calperxd/tangnano9k-kr260-hat/hardware/renders/pcb_iso_bottom.png

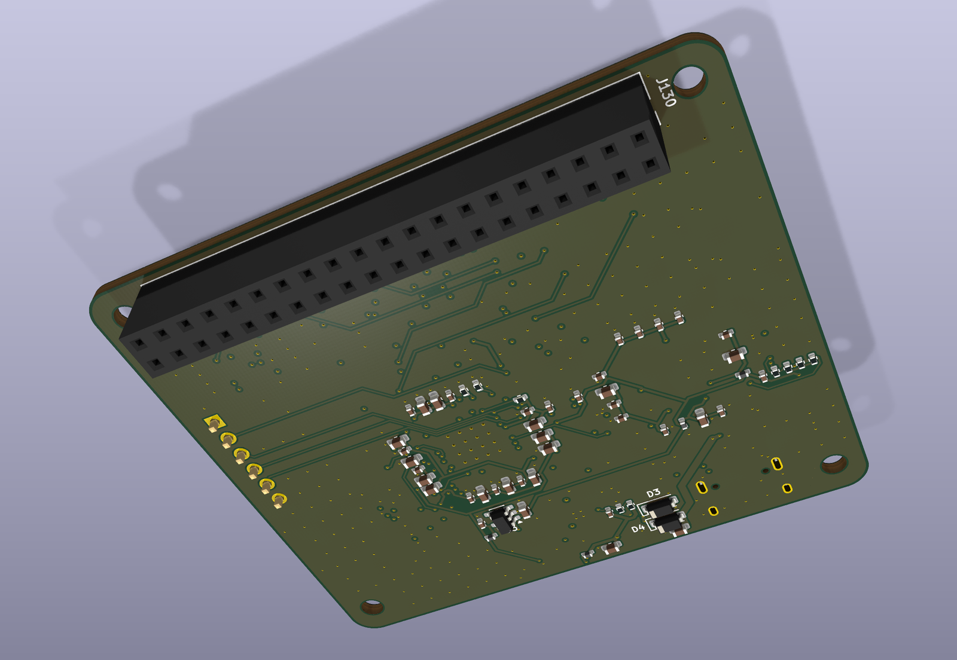
hardware/renders/pcb_iso_bottom.png
