calperxd/tangnano9k-kr260-hat/hardware/production/jlcpcb_parts.csv

Value|Footprint | Qty | LCSC | Manufacturer | MPN | Note
18pF|C_0402_1005Metric | 3 | C1549 | FH Guangdong Fenghua Advanced Tech | 0402CG180J500NT | basic part
10uF|C_0603_1608Metric | 17 | C19702 | Samsung Electro Mechanics | CL10A106KP8NNNC | basic part
22uF|C_0603_1608Metric | 4 | C86295 | Samsung | CL10A226MP8NUNE | 10 V X5R; on +5V and PWR_1V8_RAW
2.2uF|C_0402_1005Metric | 3 | C386077 | Taiyo Yuden | TMK105CBJ225KV-F | 25 V; C10/C13 on +5V
100nF|C_0402_1005Metric | 30 | C1525 | Samsung | CL05B104KO5NNNC | basic part
4.7uF|C_0603_1608Metric | 2 | C19666 | Samsung Electro Mechanics | CL10A475KO8NNNC | basic part
3.3uF|C_0603_1608Metric | 1 | C51412 | Samsung Electro Mechanics | CL10A335KP8NNNC
27pF|C_0402_1005Metric | 2 | C1557 | FH Guangdong Fenghua Advanced Tech | 0402CG270J500NT
SMAJ5.0A|D_SMA | 1 | C83329 | Littelfuse | SMAJ5.0A
B5819W|D_SOD-123 | 2 | C8598 | Jiangsu Changjing Electronics Technology Co Ltd | B5819W SL | basic part; USB-C / J21 5V OR-ing (D3/D4)
LED orange (power)|LED_0603_1608Metric | 1 | C157740 | Lite-On | LTST-C190KFKT
0402ESDA-05N|D_0402_1005Metric | 7 | C316049 | BORN | 0402ESDA-05N
LED orange|LED_0603_1608Metric | 6 | C157740 | Lite-On | LTST-C190KFKT
PTC 0.5A hold (size per PWR-04)|Fuse_1206_3216Metric | 1 | C70077 | TECHFUSE | nSMD050-33V | 0.5 A hold; rating still Pending (PWR-04)
UPZ1005D121-1R3TF|L_0402_1005Metric | 7 | C96993 | Sunlord | UPZ1005D121-1R3TF
USB_C_USB2.0_16P|USB_C_Receptacle_HRO_TYPE-C-31-M-12 | 1 | C165948 | Korean Hroparts Elec | TYPE-C-31-M-12
microSD (TF)|microSD_HC_Molex_104031-0811 | 1 | C585350 | MOLEX | 1040310811
JTAG ext. 1V8|PinHeader_1x06_P2.54mm_Vertical | 1 | C492405 | XFCN | PZ254V-11-06P | THT; optional external JTAG header
KR260 J21 (2x20 female, bottom side)|PinSocket_2x20_P2.54mm_Vertical | 1 | C132132 | CONNFLY | DS1023-2*20SF11 | THT on the bottom side; 8.5 mm insulator height, stack height Pending (XTP744)
2.2uH|L_Murata_DFE201610P | 3 | C237554 | Murata Electronics | DFE201610P-2R2M=P2
5.1k|R_0402_1005Metric | 2 | C25905 | UNI ROYAL Uniroyal Elec | 0402WGF5101TCE | basic part
680k|R_0402_1005Metric | 2 | C163456 | YAGEO | RC0402FR-07680KL
150k|R_0402_1005Metric | 3 | C25755 | UNI ROYAL Uniroyal Elec | 0402WGF1503TCE
300k|R_0402_1005Metric | 1 | C25774 | UNI ROYAL Uniroyal Elec | 0402WGF3003TCE
1k|R_0402_1005Metric | 2 | C11702 | UNI ROYAL Uniroyal Elec | 0402WGF1001TCE | basic part
4.7k|R_0402_1005Metric | 7 | C25900 | UNI ROYAL Uniroyal Elec | 0402WGF4701TCE | basic part
10k|R_0402_1005Metric | 10 | C25744 | UNI ROYAL Uniroyal Elec | 0402WGF1002TCE | basic part
22R|R_0402_1005Metric | 21 | C25092 | UNI ROYAL Uniroyal Elec | 0402WGF220JTCE | basic part
0R|R_0402_1005Metric | 1 | C17168 | UNI ROYAL Uniroyal Elec | 0402WGF0000TCE | basic part
12k 1%|R_0402_1005Metric | 1 | C25752 | UNI ROYAL Uniroyal Elec | 0402WGF1202TCE | basic part
2.2k|R_0402_1005Metric | 1 | C25879 | UNI ROYAL Uniroyal Elec | 0402WGF2201TCE | basic part
3.3k|R_0402_1005Metric | 3 | C25890 | UNI ROYAL Uniroyal Elec | 0402WGF3301TCE | basic part
100k|R_0402_1005Metric | 2 | C25741 | UNI ROYAL Uniroyal Elec | 0402WGF1003TCE | basic part
S1 (user button)|SW_SPST_PTS810 | 1 | C221895 | C&K | PTS810SJG250SMTRLFS
S2 (user button, JTAGSEL_N)|SW_SPST_PTS810 | 1 | C221895 | C&K | PTS810SJG250SMTRLFS
USBLC6-2SC6|SOT-23-6 | 1 | C7519 | STMicroelectronics | USBLC6-2SC6
TMI7003C|QFN-20-1EP_3x3mm_P0.4mm_EP1.65x1.65mm | 1 | C840566 | TMI | TMI7003C | extended part; pinout and 2.5-5.5 V input checked against datasheet V1.5
ME6211C12M5|SOT-23-5 | 1 | C236672 | MICRONE Nanjing Micro One Elec | ME6211C12M5G-N
GW1NR-LV9QN88PC6/I5|GW1NR_QN88P_10x10mm_P0.4mm_EP6.8mm | 1 |  | Gowin | GW1NR-LV9QN88PC6/I5 | not in the JLCPCB stock snapshot: Global Sourcing or consigned
W25Q32JVZPIQ|WSON-8-1EP_6x5mm_P1.27mm_EP3.4x4mm | 1 | C571260 | Winbond | W25Q32JVZPIQ | Proposed replacement for P25Q32U
FT2232HL|LQFP-64_10x10mm_P0.5mm | 1 | C27882 | FTDI | FT2232HL-REEL
93LC56B|SOIC-8_3.9x4.9mm_P1.27mm | 1 | C6164 | Microchip Tech | 93LC56BT-I/SN
SN74AVC4T774PW|TSSOP-16_4.4x5mm_P0.65mm | 1 | C129363 | Texas Instruments | SN74AVC4T774PWR
74LVC244A|TSSOP-20_4.4x6.5mm_P0.65mm | 3 | C7668 | Texas Instruments | SN74LVC244APWR
74LVC3G17|VSSOP-8_2.3x2mm_P0.5mm | 1 | C68245 | Texas Instruments | SN74LVC3G17DCUR | TI part required for Ioff (ISO-13)
74LVC1G00|SOT-23-5 | 1 | C7826 | Texas Instruments | SN74LVC1G00DBVR | TI part required for Ioff (ISO-06)
27MHz|Oscillator_SMD_Abracon_ASE-4Pin_3.2x2.5mm | 1 | C20617591 | YXC | OT2JI-111-27M | CMOS, 1.8-3.3 V, +/-20 ppm; powered from +3V3
12MHz ±30ppm|Crystal_SMD_3225-4Pin_3.2x2.5mm | 1 | C9002 | YXC Crystal Oscillators | X322512MSB4SI | basic part
