calperxd/tangnano9k-kr260-hat/docs/pinout-j21.csv

j21_pin | kr260_net | carrier_components | som_pin | k26_package_pin | k26_bank_vcco | k26_function | hat_net | gowin_pin_bank | direction | power_off_state | source | hat_silkscreen
1 | RPI_3V3 | U74 STMPS2161STR power switch, PL_3V3 → RPI_3V3 | — | — | — | Not applicable: 3.3 V power (RPi pinout, S3) | Proposed: no power connection on the HAT (ISO-01, ISO-02) | — | Proposed: not applicable (KR260 power, not used by the HAT) | Proposed: no connection on the HAT; no interconnection of supplies (ISO-01, ISO-02) | F12 (carrier schematic 038-05101-01 rev A02) sheet 12; same as S3 (standard Raspberry Pi pinout); allocation: rev. 0.4 proposal (preliminary schematic hardware/) | 3V3
2 | RPI_5V0 | U73 STMPS2161STR power switch, 5V0_IN → RPI_5V0 | — | — | — | Not applicable: 5 V power (RPi pinout, S3) | Proposed: J21_5V, the HAT 5 V input: to +5V through the Schottky D4 (B5819W), OR-ed with the USB-C through D3 (PWR-01, Decided in rev. 0.6); 10 µF C14 on the input | — | Proposed: KR260 → HAT power (RPI_5V0, 1.0 A per rail, F1) | Proposed: D4 keeps the HAT +5V (from the USB-C) out of the KR260 5 V; no interconnection of supplies (ISO-01, ISO-04) | F12 (carrier schematic 038-05101-01 rev A02) sheet 12; same as S3 (standard Raspberry Pi pinout); allocation: rev. 0.4 proposal (preliminary schematic hardware/) | 5V
3 | RPI_GPIO2_SDA (HDC02) | 4.70k pull-up to RPI_3V3 (R326/R327 on contacts 3/5) | som240_2_d54 | AE15 | Bank 44 (all 24 I/Os of the bank on J21, according to S1/F11); VCCO = PL_3V3 (VCCO_HDC, F12 sheet 7; bank VCCO pin som240_2_d59 in F13); I/O standard in S1: LVCMOS33 | PL (S1); IO_L1P_AD15P_44; RPi signal GPIO2 (I²C SDA); no HDGC | Proposed: reserved, no connection on the HAT (the carrier pulls GPIO2/3 up to RPI_3V3 with 4.70k, R326/R327, F12) | Proposed: no connection to the Gowin | Proposed: unused by the HAT (reserved) | Proposed: not driven by the HAT (no connection; ISO-09) | F12 (carrier schematic 038-05101-01 rev A02) sheet 12: J21 → HDC02, sheet 7: HDC02 → som240_2_d54; F13 (Kria_K26_SOM_Rev1.xdc): som240_2_d54 → AE15 (IO_L1P_AD15P_44, bank 44); same as S1 (XDC Hackster 2022) and F11 (xczu5evsfvc784pkg.txt); consistent with S2 (LogicTronix); allocation: rev. 0.4 proposal (preliminary schematic hardware/) | NC
4 | RPI_5V0 | U73 STMPS2161STR power switch, 5V0_IN → RPI_5V0 | — | — | — | Not applicable: 5 V power (RPi pinout, S3) | Proposed: J21_5V, the HAT 5 V input: to +5V through the Schottky D4 (B5819W), OR-ed with the USB-C through D3 (PWR-01, Decided in rev. 0.6); 10 µF C14 on the input | — | Proposed: KR260 → HAT power (RPI_5V0, 1.0 A per rail, F1) | Proposed: D4 keeps the HAT +5V (from the USB-C) out of the KR260 5 V; no interconnection of supplies (ISO-01, ISO-04) | F12 (carrier schematic 038-05101-01 rev A02) sheet 12; same as S3 (standard Raspberry Pi pinout); allocation: rev. 0.4 proposal (preliminary schematic hardware/) | 5V
5 | RPI_GPIO3_SCL (HDC03) | 4.70k pull-up to RPI_3V3 (R326/R327 on contacts 3/5) | som240_2_d56 | AE14 | Bank 44 (all 24 I/Os of the bank on J21, according to S1/F11); VCCO = PL_3V3 (VCCO_HDC, F12 sheet 7; bank VCCO pin som240_2_d59 in F13); I/O standard in S1: LVCMOS33 | PL (S1); IO_L1N_AD15N_44; RPi signal GPIO3 (I²C SCL); no HDGC | Proposed: reserved, no connection on the HAT (the carrier pulls GPIO2/3 up to RPI_3V3 with 4.70k, R326/R327, F12) | Proposed: no connection to the Gowin | Proposed: unused by the HAT (reserved) | Proposed: not driven by the HAT (no connection; ISO-09) | F12 (carrier schematic 038-05101-01 rev A02) sheet 12: J21 → HDC03, sheet 7: HDC03 → som240_2_d56; F13 (Kria_K26_SOM_Rev1.xdc): som240_2_d56 → AE14 (IO_L1N_AD15N_44, bank 44); same as S1 (XDC Hackster 2022) and F11 (xczu5evsfvc784pkg.txt); consistent with S2 (LogicTronix); allocation: rev. 0.4 proposal (preliminary schematic hardware/) | NC
6 | GND | none (GND) | — | — | — | Not applicable: GND (RPi pinout, S3) | Proposed: GND, connected to the HAT ground plane (ISO-03) | — | Proposed: not applicable (GND) | Proposed: GND always connected to the plane (ISO-03) | F12 (carrier schematic 038-05101-01 rev A02) sheet 12; same as S3 (standard Raspberry Pi pinout); allocation: rev. 0.4 proposal (preliminary schematic hardware/) | GND
7 | RPI_GPIO4_GPCLK0 (HDC04) | none (direct to SOM240_2) | som240_2_d57 | AG14 | Bank 44 (all 24 I/Os of the bank on J21, according to S1/F11); VCCO = PL_3V3 (VCCO_HDC, F12 sheet 7; bank VCCO pin som240_2_d59 in F13); I/O standard in S1: LVCMOS33 | PL (S1); IO_L2P_AD14P_44; RPi signal GPIO4; no HDGC | Proposed: LINK_D0 (bit order revisable during routing) | Proposed: GW1NR pin 68 (IOT42B), bank 1, VCCIO1 3.3 V; via U130 1A2→1Y2, R132 22R | Proposed: HAT → KR260; driver enabled only with LINK_OE_N low (OE in hardware: NAND of LINK_EN and LINK_TX_EN, ISO-11/ISO-15) | Proposed: before LINK_EN is high, HAT driver (74LVC244A, Ioff) in high impedance, no pull proposed | F12 (carrier schematic 038-05101-01 rev A02) sheet 12: J21 → HDC04, sheet 7: HDC04 → som240_2_d57; F13 (Kria_K26_SOM_Rev1.xdc): som240_2_d57 → AG14 (IO_L2P_AD14P_44, bank 44); same as S1 (XDC Hackster 2022) and F11 (xczu5evsfvc784pkg.txt); allocation: rev. 0.4 proposal (preliminary schematic hardware/) | D0
8 | RPI_GPIO14_TXD (HDC14) | none (direct to SOM240_2) | som240_2_b54 | W14 | Bank 44 (all 24 I/Os of the bank on J21, according to S1/F11); VCCO = PL_3V3 (VCCO_HDC, F12 sheet 7; bank VCCO pin som240_2_d59 in F13); I/O standard in S1: LVCMOS33 | PL (S1); IO_L9P_AD11P_44; RPi signal GPIO14; no HDGC | Proposed: LINK_D1 (bit order revisable during routing) | Proposed: GW1NR pin 69 (IOT42A), bank 1, VCCIO1 3.3 V; via U130 1A3→1Y3, R133 22R | Proposed: HAT → KR260; driver enabled only with LINK_OE_N low (OE in hardware: NAND of LINK_EN and LINK_TX_EN, ISO-11/ISO-15) | Proposed: before LINK_EN is high, HAT driver (74LVC244A, Ioff) in high impedance, no pull proposed | F12 (carrier schematic 038-05101-01 rev A02) sheet 12: J21 → HDC14, sheet 7: HDC14 → som240_2_b54; F13 (Kria_K26_SOM_Rev1.xdc): som240_2_b54 → W14 (IO_L9P_AD11P_44, bank 44); same as S1 (XDC Hackster 2022) and F11 (xczu5evsfvc784pkg.txt); allocation: rev. 0.4 proposal (preliminary schematic hardware/) | D1
9 | GND | none (GND) | — | — | — | Not applicable: GND (RPi pinout, S3) | Proposed: GND, connected to the HAT ground plane (ISO-03) | — | Proposed: not applicable (GND) | Proposed: GND always connected to the plane (ISO-03) | F12 (carrier schematic 038-05101-01 rev A02) sheet 12; same as S3 (standard Raspberry Pi pinout); allocation: rev. 0.4 proposal (preliminary schematic hardware/) | GND
10 | RPI_GPIO15_RXD (HDC15) | none (direct to SOM240_2) | som240_2_b56 | W13 | Bank 44 (all 24 I/Os of the bank on J21, according to S1/F11); VCCO = PL_3V3 (VCCO_HDC, F12 sheet 7; bank VCCO pin som240_2_d59 in F13); I/O standard in S1: LVCMOS33 | PL (S1); IO_L9N_AD11N_44; RPi signal GPIO15; no HDGC | Proposed: LINK_D2 (bit order revisable during routing) | Proposed: GW1NR pin 70 (IOT41B), bank 1, VCCIO1 3.3 V; via U130 2A0→2Y0, R134 22R | Proposed: HAT → KR260; driver enabled only with LINK_OE_N low (OE in hardware: NAND of LINK_EN and LINK_TX_EN, ISO-11/ISO-15) | Proposed: before LINK_EN is high, HAT driver (74LVC244A, Ioff) in high impedance, no pull proposed | F12 (carrier schematic 038-05101-01 rev A02) sheet 12: J21 → HDC15, sheet 7: HDC15 → som240_2_b56; F13 (Kria_K26_SOM_Rev1.xdc): som240_2_b56 → W13 (IO_L9N_AD11N_44, bank 44); same as S1 (XDC Hackster 2022) and F11 (xczu5evsfvc784pkg.txt); allocation: rev. 0.4 proposal (preliminary schematic hardware/) | D2
11 | RPI_GPIO17 (HDC17) | none (direct to SOM240_2) | som240_2_b58 | AB14 | Bank 44 (all 24 I/Os of the bank on J21, according to S1/F11); VCCO = PL_3V3 (VCCO_HDC, F12 sheet 7; bank VCCO pin som240_2_d59 in F13); I/O standard in S1: LVCMOS33 | PL (S1); IO_L8N_HDGC_44; RPi signal GPIO17; HDGC N side: with a single-ended clock on the P side, regular I/O only (F7) | Proposed: LINK_D3 (bit order revisable during routing) | Proposed: GW1NR pin 71 (IOT41A), bank 1, VCCIO1 3.3 V; via U130 2A1→2Y1, R135 22R | Proposed: HAT → KR260; driver enabled only with LINK_OE_N low (OE in hardware: NAND of LINK_EN and LINK_TX_EN, ISO-11/ISO-15) | Proposed: before LINK_EN is high, HAT driver (74LVC244A, Ioff) in high impedance, no pull proposed | F12 (carrier schematic 038-05101-01 rev A02) sheet 12: J21 → HDC17, sheet 7: HDC17 → som240_2_b58; F13 (Kria_K26_SOM_Rev1.xdc): som240_2_b58 → AB14 (IO_L8N_HDGC_44, bank 44); same as S1 (XDC Hackster 2022) and F11 (xczu5evsfvc784pkg.txt); HDGC: F5, F7; allocation: rev. 0.4 proposal (preliminary schematic hardware/) | D3
12 | RPI_GPIO18_PCM_CLK (HDC18) | none (direct to SOM240_2) | som240_2_a54 | Y14 | Bank 44 (all 24 I/Os of the bank on J21, according to S1/F11); VCCO = PL_3V3 (VCCO_HDC, F12 sheet 7; bank VCCO pin som240_2_d59 in F13); I/O standard in S1: LVCMOS33 | PL (S1); IO_L10P_AD10P_44; RPi signal GPIO18; no HDGC | Proposed: LINK_D4 (bit order revisable during routing) | Proposed: GW1NR pin 72 (IOT39B), bank 1, VCCIO1 3.3 V; via U130 2A2→2Y2, R136 22R | Proposed: HAT → KR260; driver enabled only with LINK_OE_N low (OE in hardware: NAND of LINK_EN and LINK_TX_EN, ISO-11/ISO-15) | Proposed: before LINK_EN is high, HAT driver (74LVC244A, Ioff) in high impedance, no pull proposed | F12 (carrier schematic 038-05101-01 rev A02) sheet 12: J21 → HDC18, sheet 7: HDC18 → som240_2_a54; F13 (Kria_K26_SOM_Rev1.xdc): som240_2_a54 → Y14 (IO_L10P_AD10P_44, bank 44); same as S1 (XDC Hackster 2022) and F11 (xczu5evsfvc784pkg.txt); allocation: rev. 0.4 proposal (preliminary schematic hardware/) | D4
13 | RPI_GPIO27 (HDB23) | none (direct to SOM240_2) | som240_2_a52 | AB9 | Bank 43 (shared with Pmods 3 and 4, according to S1); VCCO = PL_3V3 (VCCO_HDB, F12 sheet 7; bank VCCO pin som240_2_b59 in F13); I/O standard in S1: LVCMOS33 | PL (S1); IO_L12N_AD0N_43; RPi signal GPIO27; no HDGC | Proposed: LINK_RESET_N | Proposed: GW1NR pin 42 (IOB41B), bank 2, VCCIO2 3.3 V; via U133C (74LVC3G17) 3→5 | Proposed: KR260 → HAT; enters through a Schmitt receiver with Ioff (74LVC3G17, ISO-13) | Proposed: 3.3k pull-down on the J21 side (R152, ISO-12): low = reset = do not transmit; HAT off: receiver with Ioff; LINK_EN (bank 44) does not indicate the VCCO of bank 43 | F12 (carrier schematic 038-05101-01 rev A02) sheet 12: J21 → HDB23, sheet 7: HDB23 → som240_2_a52; F13 (Kria_K26_SOM_Rev1.xdc): som240_2_a52 → AB9 (IO_L12N_AD0N_43, bank 43); same as S1 (XDC Hackster 2022) and F11 (xczu5evsfvc784pkg.txt); allocation: rev. 0.4 proposal (preliminary schematic hardware/) | RST
14 | GND | none (GND) | — | — | — | Not applicable: GND (RPi pinout, S3) | Proposed: GND, connected to the HAT ground plane (ISO-03) | — | Proposed: not applicable (GND) | Proposed: GND always connected to the plane (ISO-03) | F12 (carrier schematic 038-05101-01 rev A02) sheet 12; same as S3 (standard Raspberry Pi pinout); allocation: rev. 0.4 proposal (preliminary schematic hardware/) | GND
15 | RPI_GPIO22 (HDC22) | none (direct to SOM240_2) | som240_2_a59 | Y12 | Bank 44 (all 24 I/Os of the bank on J21, according to S1/F11); VCCO = PL_3V3 (VCCO_HDC, F12 sheet 7; bank VCCO pin som240_2_d59 in F13); I/O standard in S1: LVCMOS33 | PL (S1); IO_L12P_AD8P_44; RPi signal GPIO22; no HDGC | Proposed: LINK_D5 (bit order revisable during routing) | Proposed: GW1NR pin 75 (IOT38A), bank 1, VCCIO1 3.3 V; via U130 2A3→2Y3, R137 22R | Proposed: HAT → KR260; driver enabled only with LINK_OE_N low (OE in hardware: NAND of LINK_EN and LINK_TX_EN, ISO-11/ISO-15) | Proposed: before LINK_EN is high, HAT driver (74LVC244A, Ioff) in high impedance, no pull proposed | F12 (carrier schematic 038-05101-01 rev A02) sheet 12: J21 → HDC22, sheet 7: HDC22 → som240_2_a59; F13 (Kria_K26_SOM_Rev1.xdc): som240_2_a59 → Y12 (IO_L12P_AD8P_44, bank 44); same as S1 (XDC Hackster 2022) and F11 (xczu5evsfvc784pkg.txt); allocation: rev. 0.4 proposal (preliminary schematic hardware/) | D5
16 | RPI_GPIO23 (HDC23) | none (direct to SOM240_2) | som240_2_a60 | AA12 | Bank 44 (all 24 I/Os of the bank on J21, according to S1/F11); VCCO = PL_3V3 (VCCO_HDC, F12 sheet 7; bank VCCO pin som240_2_d59 in F13); I/O standard in S1: LVCMOS33 | PL (S1); IO_L12N_AD8N_44; RPi signal GPIO23; no HDGC | Proposed: LINK_D6 (bit order revisable during routing) | Proposed: GW1NR pin 76 (IOT37B), bank 1, VCCIO1 3.3 V; via U131 1A0→1Y0, R138 22R | Proposed: HAT → KR260; driver enabled only with LINK_OE_N low (OE in hardware: NAND of LINK_EN and LINK_TX_EN, ISO-11/ISO-15) | Proposed: before LINK_EN is high, HAT driver (74LVC244A, Ioff) in high impedance, no pull proposed | F12 (carrier schematic 038-05101-01 rev A02) sheet 12: J21 → HDC23, sheet 7: HDC23 → som240_2_a60; F13 (Kria_K26_SOM_Rev1.xdc): som240_2_a60 → AA12 (IO_L12N_AD8N_44, bank 44); same as S1 (XDC Hackster 2022) and F11 (xczu5evsfvc784pkg.txt); consistent with S2 (LogicTronix); allocation: rev. 0.4 proposal (preliminary schematic hardware/) | D6
17 | RPI_3V3 | U74 STMPS2161STR power switch, PL_3V3 → RPI_3V3 | — | — | — | Not applicable: 3.3 V power (RPi pinout, S3) | Proposed: no power connection on the HAT (ISO-01, ISO-02) | — | Proposed: not applicable (KR260 power, not used by the HAT) | Proposed: no connection on the HAT; no interconnection of supplies (ISO-01, ISO-02) | F12 (carrier schematic 038-05101-01 rev A02) sheet 12; same as S3 (standard Raspberry Pi pinout); allocation: rev. 0.4 proposal (preliminary schematic hardware/) | 3V3
18 | RPI_GPIO24 (HDB20) | none (direct to SOM240_2) | som240_2_a48 | Y9 | Bank 43 (shared with Pmods 3 and 4, according to S1); VCCO = PL_3V3 (VCCO_HDB, F12 sheet 7; bank VCCO pin som240_2_b59 in F13); I/O standard in S1: LVCMOS33 | PL (S1); IO_L11P_AD1P_43; RPi signal GPIO24; no HDGC | Proposed: bank 43 reserve, no connection on the HAT | Proposed: no connection to the Gowin | Proposed: unused by the HAT (reserve) | Proposed: not driven by the HAT (no connection; ISO-09) | F12 (carrier schematic 038-05101-01 rev A02) sheet 12: J21 → HDB20, sheet 7: HDB20 → som240_2_a48; F13 (Kria_K26_SOM_Rev1.xdc): som240_2_a48 → Y9 (IO_L11P_AD1P_43, bank 43); same as S1 (XDC Hackster 2022) and F11 (xczu5evsfvc784pkg.txt); allocation: rev. 0.4 proposal (preliminary schematic hardware/) | NC
19 | RPI_GPIO10_MOSI (HDC10) | none (direct to SOM240_2) | som240_2_c59 | AE13 | Bank 44 (all 24 I/Os of the bank on J21, according to S1/F11); VCCO = PL_3V3 (VCCO_HDC, F12 sheet 7; bank VCCO pin som240_2_d59 in F13); I/O standard in S1: LVCMOS33 | PL (S1); IO_L4P_AD12P_44; RPi signal GPIO10; no HDGC | Proposed: LINK_D7 (bit order revisable during routing) | Proposed: GW1NR pin 77 (IOT37A), bank 1, VCCIO1 3.3 V; via U131 1A1→1Y1, R139 22R | Proposed: HAT → KR260; driver enabled only with LINK_OE_N low (OE in hardware: NAND of LINK_EN and LINK_TX_EN, ISO-11/ISO-15) | Proposed: before LINK_EN is high, HAT driver (74LVC244A, Ioff) in high impedance, no pull proposed | F12 (carrier schematic 038-05101-01 rev A02) sheet 12: J21 → HDC10, sheet 7: HDC10 → som240_2_c59; F13 (Kria_K26_SOM_Rev1.xdc): som240_2_c59 → AE13 (IO_L4P_AD12P_44, bank 44); same as S1 (XDC Hackster 2022) and F11 (xczu5evsfvc784pkg.txt); allocation: rev. 0.4 proposal (preliminary schematic hardware/) | D7
20 | GND | none (GND) | — | — | — | Not applicable: GND (RPi pinout, S3) | Proposed: GND, connected to the HAT ground plane (ISO-03) | — | Proposed: not applicable (GND) | Proposed: GND always connected to the plane (ISO-03) | F12 (carrier schematic 038-05101-01 rev A02) sheet 12; same as S3 (standard Raspberry Pi pinout); allocation: rev. 0.4 proposal (preliminary schematic hardware/) | GND
21 | RPI_GPIO9_MISO (HDC09) | none (direct to SOM240_2) | som240_2_c58 | AC13 | Bank 44 (all 24 I/Os of the bank on J21, according to S1/F11); VCCO = PL_3V3 (VCCO_HDC, F12 sheet 7; bank VCCO pin som240_2_d59 in F13); I/O standard in S1: LVCMOS33 | PL (S1); IO_L6N_HDGC_44; RPi signal GPIO9; HDGC N side: with a single-ended clock on the P side, regular I/O only (F7) | Proposed: LINK_D8 (bit order revisable during routing) | Proposed: GW1NR pin 48 (IOR24B), bank 1, VCCIO1 3.3 V; via U131 1A3→1Y3, R141 22R | Proposed: HAT → KR260; driver enabled only with LINK_OE_N low (OE in hardware: NAND of LINK_EN and LINK_TX_EN, ISO-11/ISO-15) | Proposed: before LINK_EN is high, HAT driver (74LVC244A, Ioff) in high impedance, no pull proposed | F12 (carrier schematic 038-05101-01 rev A02) sheet 12: J21 → HDC09, sheet 7: HDC09 → som240_2_c58; F13 (Kria_K26_SOM_Rev1.xdc): som240_2_c58 → AC13 (IO_L6N_HDGC_44, bank 44); same as S1 (XDC Hackster 2022) and F11 (xczu5evsfvc784pkg.txt); HDGC: F5, F7; allocation: rev. 0.4 proposal (preliminary schematic hardware/) | D8
22 | RPI_GPIO25 (HDB21) | none (direct to SOM240_2) | som240_2_a50 | AA8 | Bank 43 (shared with Pmods 3 and 4, according to S1); VCCO = PL_3V3 (VCCO_HDB, F12 sheet 7; bank VCCO pin som240_2_b59 in F13); I/O standard in S1: LVCMOS33 | PL (S1); IO_L11N_AD1N_43; RPi signal GPIO25; no HDGC | Proposed: bank 43 reserve, no connection on the HAT | Proposed: no connection to the Gowin | Proposed: unused by the HAT (reserve) | Proposed: not driven by the HAT (no connection; ISO-09) | F12 (carrier schematic 038-05101-01 rev A02) sheet 12: J21 → HDB21, sheet 7: HDB21 → som240_2_a50; F13 (Kria_K26_SOM_Rev1.xdc): som240_2_a50 → AA8 (IO_L11N_AD1N_43, bank 43); same as S1 (XDC Hackster 2022) and F11 (xczu5evsfvc784pkg.txt); allocation: rev. 0.4 proposal (preliminary schematic hardware/) | NC
23 | RPI_GPIO11_SCLK (HDC11) | none (direct to SOM240_2) | som240_2_c60 | AF13 | Bank 44 (all 24 I/Os of the bank on J21, according to S1/F11); VCCO = PL_3V3 (VCCO_HDC, F12 sheet 7; bank VCCO pin som240_2_d59 in F13); I/O standard in S1: LVCMOS33 | PL (S1); IO_L4N_AD12N_44; RPi signal GPIO11; no HDGC | Proposed: LINK_D9 (bit order revisable during routing) | Proposed: GW1NR pin 49 (IOR24A), bank 1, VCCIO1 3.3 V; via U131 1A2→1Y2, R140 22R | Proposed: HAT → KR260; driver enabled only with LINK_OE_N low (OE in hardware: NAND of LINK_EN and LINK_TX_EN, ISO-11/ISO-15) | Proposed: before LINK_EN is high, HAT driver (74LVC244A, Ioff) in high impedance, no pull proposed | F12 (carrier schematic 038-05101-01 rev A02) sheet 12: J21 → HDC11, sheet 7: HDC11 → som240_2_c60; F13 (Kria_K26_SOM_Rev1.xdc): som240_2_c60 → AF13 (IO_L4N_AD12N_44, bank 44); same as S1 (XDC Hackster 2022) and F11 (xczu5evsfvc784pkg.txt); allocation: rev. 0.4 proposal (preliminary schematic hardware/) | D9
24 | RPI_GPIO8_CE0 (HDC08_CC) | none (direct to SOM240_2) | som240_2_c56 | AC14 | Bank 44 (all 24 I/Os of the bank on J21, according to S1/F11); VCCO = PL_3V3 (VCCO_HDC, F12 sheet 7; bank VCCO pin som240_2_d59 in F13); I/O standard in S1: LVCMOS33 | PL (S1); IO_L6P_HDGC_44; RPi signal GPIO8; HDGC P side: suitable for a single-ended clock; direct access only to global clock buffers (F5, F7) | Proposed: LINK_D10 (bit order revisable during routing); alternative for LINK_CLK (P-side HDGC), at the cost of reassigning two data signals | Proposed: GW1NR pin 50 (IOR22B), bank 1, VCCIO1 3.3 V; via U131 2A0→2Y0, R142 22R | Proposed: HAT → KR260; driver enabled only with LINK_OE_N low (OE in hardware: NAND of LINK_EN and LINK_TX_EN, ISO-11/ISO-15) | Proposed: before LINK_EN is high, HAT driver (74LVC244A, Ioff) in high impedance, no pull proposed | F12 (carrier schematic 038-05101-01 rev A02) sheet 12: J21 → HDC08_CC, sheet 7: HDC08_CC → som240_2_c56; F13 (Kria_K26_SOM_Rev1.xdc): som240_2_c56 → AC14 (IO_L6P_HDGC_44, bank 44); same as S1 (XDC Hackster 2022) and F11 (xczu5evsfvc784pkg.txt); HDGC: F5, F7; allocation: rev. 0.4 proposal (preliminary schematic hardware/) | D10
25 | GND | none (GND) | — | — | — | Not applicable: GND (RPi pinout, S3) | Proposed: GND, connected to the HAT ground plane (ISO-03) | — | Proposed: not applicable (GND) | Proposed: GND always connected to the plane (ISO-03) | F12 (carrier schematic 038-05101-01 rev A02) sheet 12; same as S3 (standard Raspberry Pi pinout); allocation: rev. 0.4 proposal (preliminary schematic hardware/) | GND
26 | RPI_GPIO7_CE1 (HDC07) | none (direct to SOM240_2) | som240_2_c55 | AH13 | Bank 44 (all 24 I/Os of the bank on J21, according to S1/F11); VCCO = PL_3V3 (VCCO_HDC, F12 sheet 7; bank VCCO pin som240_2_d59 in F13); I/O standard in S1: LVCMOS33 | PL (S1); IO_L3N_AD13N_44; RPi signal GPIO7; no HDGC | Proposed: LINK_D11 (bit order revisable during routing) | Proposed: GW1NR pin 53 (IOR15B/DOUT/WE_N), bank 1, VCCIO1 3.3 V; via U131 2A1→2Y1, R143 22R | Proposed: HAT → KR260; driver enabled only with LINK_OE_N low (OE in hardware: NAND of LINK_EN and LINK_TX_EN, ISO-11/ISO-15) | Proposed: before LINK_EN is high, HAT driver (74LVC244A, Ioff) in high impedance, no pull proposed | F12 (carrier schematic 038-05101-01 rev A02) sheet 12: J21 → HDC07, sheet 7: HDC07 → som240_2_c55; F13 (Kria_K26_SOM_Rev1.xdc): som240_2_c55 → AH13 (IO_L3N_AD13N_44, bank 44); same as S1 (XDC Hackster 2022) and F11 (xczu5evsfvc784pkg.txt); allocation: rev. 0.4 proposal (preliminary schematic hardware/) | D11
27 | RPI_GPIO0_ID_SD (HDC00_CC) | 3.90k pull-up to RPI_3V3 (R330/R331 on contacts 27/28) | som240_2_d52 | AD15 | Bank 44 (all 24 I/Os of the bank on J21, according to S1/F11); VCCO = PL_3V3 (VCCO_HDC, F12 sheet 7; bank VCCO pin som240_2_d59 in F13); I/O standard in S1: LVCMOS33 | PL (S1); IO_L5P_HDGC_44; RPi signal GPIO0 (ID_SD); HDGC P side: suitable for a single-ended clock; direct access only to global clock buffers (F5, F7) | Proposed: reserved, no connection on the HAT (ID pin, ID_SD/ID_SC, pulled up to RPI_3V3 with 3.90k on the carrier, R330/R331, F12; identification EEPROM proposed out of scope, J21-05) | Proposed: no connection to the Gowin | Proposed: unused by the HAT (reserved) | Proposed: not driven by the HAT (no connection; ISO-09) | F12 (carrier schematic 038-05101-01 rev A02) sheet 12: J21 → HDC00_CC, sheet 7: HDC00_CC → som240_2_d52; F13 (Kria_K26_SOM_Rev1.xdc): som240_2_d52 → AD15 (IO_L5P_HDGC_44, bank 44); same as S1 (XDC Hackster 2022) and F11 (xczu5evsfvc784pkg.txt); HDGC: F5, F7; allocation: rev. 0.4 proposal (preliminary schematic hardware/) | NC
28 | RPI_GPIO1_ID_SC (HDC01) | 3.90k pull-up to RPI_3V3 (R330/R331 on contacts 27/28) | som240_2_d53 | AD14 | Bank 44 (all 24 I/Os of the bank on J21, according to S1/F11); VCCO = PL_3V3 (VCCO_HDC, F12 sheet 7; bank VCCO pin som240_2_d59 in F13); I/O standard in S1: LVCMOS33 | PL (S1); IO_L5N_HDGC_44; RPi signal GPIO1 (ID_SC); HDGC N side: with a single-ended clock on the P side, regular I/O only (F7) | Proposed: reserved, no connection on the HAT (ID pin, ID_SD/ID_SC, pulled up to RPI_3V3 with 3.90k on the carrier, R330/R331, F12; identification EEPROM proposed out of scope, J21-05) | Proposed: no connection to the Gowin | Proposed: unused by the HAT (reserved) | Proposed: not driven by the HAT (no connection; ISO-09) | F12 (carrier schematic 038-05101-01 rev A02) sheet 12: J21 → HDC01, sheet 7: HDC01 → som240_2_d53; F13 (Kria_K26_SOM_Rev1.xdc): som240_2_d53 → AD14 (IO_L5N_HDGC_44, bank 44); same as S1 (XDC Hackster 2022) and F11 (xczu5evsfvc784pkg.txt); HDGC: F5, F7; allocation: rev. 0.4 proposal (preliminary schematic hardware/) | NC
29 | RPI_GPIO5 (HDC05) | none (direct to SOM240_2) | som240_2_d58 | AH14 | Bank 44 (all 24 I/Os of the bank on J21, according to S1/F11); VCCO = PL_3V3 (VCCO_HDC, F12 sheet 7; bank VCCO pin som240_2_d59 in F13); I/O standard in S1: LVCMOS33 | PL (S1); IO_L2N_AD14N_44; RPi signal GPIO5; no HDGC | Proposed: LINK_VALID; low-activity signal on the clock diagonal | Proposed: GW1NR pin 74 (IOT38B), bank 1, VCCIO1 3.3 V; via U130 1A1→1Y1, R131 22R | Proposed: HAT → KR260; driver enabled only with LINK_OE_N low (OE in hardware: NAND of LINK_EN and LINK_TX_EN, ISO-11/ISO-15) | Proposed: before LINK_EN is high, HAT driver (74LVC244A, Ioff) in high impedance, with a 100k pull-down on the J21 side (R153; value Pending, ISO-12) | F12 (carrier schematic 038-05101-01 rev A02) sheet 12: J21 → HDC05, sheet 7: HDC05 → som240_2_d58; F13 (Kria_K26_SOM_Rev1.xdc): som240_2_d58 → AH14 (IO_L2N_AD14N_44, bank 44); same as S1 (XDC Hackster 2022) and F11 (xczu5evsfvc784pkg.txt); allocation: rev. 0.4 proposal (preliminary schematic hardware/) | VLD
30 | GND | none (GND) | — | — | — | Not applicable: GND (RPi pinout, S3) | Proposed: GND, connected to the HAT ground plane (ISO-03) | — | Proposed: not applicable (GND) | Proposed: GND always connected to the plane (ISO-03) | F12 (carrier schematic 038-05101-01 rev A02) sheet 12; same as S3 (standard Raspberry Pi pinout); allocation: rev. 0.4 proposal (preliminary schematic hardware/) | GND
31 | RPI_GPIO6 (HDC06) | none (direct to SOM240_2) | som240_2_c54 | AG13 | Bank 44 (all 24 I/Os of the bank on J21, according to S1/F11); VCCO = PL_3V3 (VCCO_HDC, F12 sheet 7; bank VCCO pin som240_2_d59 in F13); I/O standard in S1: LVCMOS33 | PL (S1); IO_L3P_AD13P_44; RPi signal GPIO6; no HDGC | Proposed: LINK_EN | Proposed: GW1NR pin 40 (IOB33B), bank 2, VCCIO2 3.3 V; via U133A (74LVC3G17) 1→7; also goes into U134 (74LVC1G00) | Proposed: KR260 → HAT; enters through a Schmitt receiver with Ioff (74LVC3G17, ISO-13); controls the OE of the output buffers via U134 (ISO-11) | Proposed: 3.3k pull-down on the J21 side (R150; R ≤ 0.8 V / 190 µA, ISO-12): floating or pulled down = do not transmit; HAT off: receiver with Ioff, no back-powering | F12 (carrier schematic 038-05101-01 rev A02) sheet 12: J21 → HDC06, sheet 7: HDC06 → som240_2_c54; F13 (Kria_K26_SOM_Rev1.xdc): som240_2_c54 → AG13 (IO_L3P_AD13P_44, bank 44); same as S1 (XDC Hackster 2022) and F11 (xczu5evsfvc784pkg.txt); allocation: rev. 0.4 proposal (preliminary schematic hardware/) | EN
32 | RPI_GPIO12_PWM0 (HDC12) | none (direct to SOM240_2) | som240_2_b52 | AA13 | Bank 44 (all 24 I/Os of the bank on J21, according to S1/F11); VCCO = PL_3V3 (VCCO_HDC, F12 sheet 7; bank VCCO pin som240_2_d59 in F13); I/O standard in S1: LVCMOS33 | PL (S1); IO_L7P_HDGC_44; RPi signal GPIO12; HDGC P side: suitable for a single-ended clock; direct access only to global clock buffers (F5, F7) | Proposed: LINK_CLK | Proposed: GW1NR pin 73 (IOT39A), bank 1, VCCIO1 3.3 V; via U130 1A0→1Y0, R130 22R | Proposed: HAT → KR260; driver enabled only with LINK_OE_N low (OE in hardware: NAND of LINK_EN and LINK_TX_EN, ISO-11/ISO-15); behavior while LINK_RESET_N is low to be defined (LINK-07) | Proposed: before LINK_EN is high, HAT driver (74LVC244A, Ioff) in high impedance, with a 100k pull-down on the J21 side (R154; value Pending, ISO-12); KR260 off or without a bitstream: LINK_EN stays low (ISO-09) | F12 (carrier schematic 038-05101-01 rev A02) sheet 12: J21 → HDC12, sheet 7: HDC12 → som240_2_b52; F13 (Kria_K26_SOM_Rev1.xdc): som240_2_b52 → AA13 (IO_L7P_HDGC_44, bank 44); same as S1 (XDC Hackster 2022) and F11 (xczu5evsfvc784pkg.txt); HDGC: F5, F7; allocation: rev. 0.4 proposal (preliminary schematic hardware/) | CLK
33 | RPI_GPIO13_PWM1 (HDC13) | none (direct to SOM240_2) | som240_2_b53 | AB13 | Bank 44 (all 24 I/Os of the bank on J21, according to S1/F11); VCCO = PL_3V3 (VCCO_HDC, F12 sheet 7; bank VCCO pin som240_2_d59 in F13); I/O standard in S1: LVCMOS33 | PL (S1); IO_L7N_HDGC_44; RPi signal GPIO13; HDGC N side: with a single-ended clock on the P side, regular I/O only (F7) | Proposed: LINK_READY; low-activity signal on the clock diagonal | Proposed: GW1NR pin 41 (IOB41A), bank 2, VCCIO2 3.3 V; via U133B (74LVC3G17) 6→2 | Proposed: KR260 → HAT; enters through a Schmitt receiver with Ioff (74LVC3G17, ISO-13) | Proposed: 3.3k pull-down on the J21 side (R151, ISO-12); HAT off: receiver with Ioff | F12 (carrier schematic 038-05101-01 rev A02) sheet 12: J21 → HDC13, sheet 7: HDC13 → som240_2_b53; F13 (Kria_K26_SOM_Rev1.xdc): som240_2_b53 → AB13 (IO_L7N_HDGC_44, bank 44); same as S1 (XDC Hackster 2022) and F11 (xczu5evsfvc784pkg.txt); HDGC: F5, F7; allocation: rev. 0.4 proposal (preliminary schematic hardware/) | RDY
34 | GND | none (GND) | — | — | — | Not applicable: GND (RPi pinout, S3) | Proposed: GND, connected to the HAT ground plane (ISO-03) | — | Proposed: not applicable (GND) | Proposed: GND always connected to the plane (ISO-03) | F12 (carrier schematic 038-05101-01 rev A02) sheet 12; same as S3 (standard Raspberry Pi pinout); allocation: rev. 0.4 proposal (preliminary schematic hardware/) | GND
35 | RPI_GPIO19_PCM_FS (HDC19) | none (direct to SOM240_2) | som240_2_a55 | Y13 | Bank 44 (all 24 I/Os of the bank on J21, according to S1/F11); VCCO = PL_3V3 (VCCO_HDC, F12 sheet 7; bank VCCO pin som240_2_d59 in F13); I/O standard in S1: LVCMOS33 | PL (S1); IO_L10N_AD10N_44; RPi signal GPIO19; no HDGC | Proposed: LINK_D12 (bit order revisable during routing) | Proposed: GW1NR pin 54 (IOR15A/DIN/CLKHOLD_N), bank 1, VCCIO1 3.3 V; via U131 2A2→2Y2, R144 22R | Proposed: HAT → KR260; driver enabled only with LINK_OE_N low (OE in hardware: NAND of LINK_EN and LINK_TX_EN, ISO-11/ISO-15) | Proposed: before LINK_EN is high, HAT driver (74LVC244A, Ioff) in high impedance, no pull proposed | F12 (carrier schematic 038-05101-01 rev A02) sheet 12: J21 → HDC19, sheet 7: HDC19 → som240_2_a55; F13 (Kria_K26_SOM_Rev1.xdc): som240_2_a55 → Y13 (IO_L10N_AD10N_44, bank 44); same as S1 (XDC Hackster 2022) and F11 (xczu5evsfvc784pkg.txt); allocation: rev. 0.4 proposal (preliminary schematic hardware/) | D12
36 | RPI_GPIO16 (HDC16_CC) | none (direct to SOM240_2) | som240_2_b57 | AB15 | Bank 44 (all 24 I/Os of the bank on J21, according to S1/F11); VCCO = PL_3V3 (VCCO_HDC, F12 sheet 7; bank VCCO pin som240_2_d59 in F13); I/O standard in S1: LVCMOS33 | PL (S1); IO_L8P_HDGC_44; RPi signal GPIO16; HDGC P side: suitable for a single-ended clock; direct access only to global clock buffers (F5, F7) | Proposed: LINK_D13 (bit order revisable during routing); alternative for LINK_CLK (P-side HDGC), at the cost of reassigning two data signals | Proposed: GW1NR pin 55 (IOR14B/SSPI_CS_N/D0), bank 1, VCCIO1 3.3 V; via U131 2A3→2Y3, R145 22R | Proposed: HAT → KR260; driver enabled only with LINK_OE_N low (OE in hardware: NAND of LINK_EN and LINK_TX_EN, ISO-11/ISO-15) | Proposed: before LINK_EN is high, HAT driver (74LVC244A, Ioff) in high impedance, no pull proposed | F12 (carrier schematic 038-05101-01 rev A02) sheet 12: J21 → HDC16_CC, sheet 7: HDC16_CC → som240_2_b57; F13 (Kria_K26_SOM_Rev1.xdc): som240_2_b57 → AB15 (IO_L8P_HDGC_44, bank 44); same as S1 (XDC Hackster 2022) and F11 (xczu5evsfvc784pkg.txt); HDGC: F5, F7; allocation: rev. 0.4 proposal (preliminary schematic hardware/) | D13
37 | RPI_GPIO26 (HDB22) | none (direct to SOM240_2) | som240_2_a51 | AB10 | Bank 43 (shared with Pmods 3 and 4, according to S1); VCCO = PL_3V3 (VCCO_HDB, F12 sheet 7; bank VCCO pin som240_2_b59 in F13); I/O standard in S1: LVCMOS33 | PL (S1); IO_L12P_AD0P_43; RPi signal GPIO26; no HDGC | Proposed: bank 43 reserve, no connection on the HAT | Proposed: no connection to the Gowin | Proposed: unused by the HAT (reserve) | Proposed: not driven by the HAT (no connection; ISO-09) | F12 (carrier schematic 038-05101-01 rev A02) sheet 12: J21 → HDB22, sheet 7: HDB22 → som240_2_a51; F13 (Kria_K26_SOM_Rev1.xdc): som240_2_a51 → AB10 (IO_L12P_AD0P_43, bank 43); same as S1 (XDC Hackster 2022) and F11 (xczu5evsfvc784pkg.txt); allocation: rev. 0.4 proposal (preliminary schematic hardware/) | NC
38 | RPI_GPIO20_PCM_DIN (HDC20) | none (direct to SOM240_2) | som240_2_a56 | W12 | Bank 44 (all 24 I/Os of the bank on J21, according to S1/F11); VCCO = PL_3V3 (VCCO_HDC, F12 sheet 7; bank VCCO pin som240_2_d59 in F13); I/O standard in S1: LVCMOS33 | PL (S1); IO_L11P_AD9P_44; RPi signal GPIO20; no HDGC | Proposed: LINK_D14 (bit order revisable during routing) | Proposed: GW1NR pin 56 (IOR14A/SO/D1), bank 1, VCCIO1 3.3 V; via U132 1A0→1Y0, R146 22R | Proposed: HAT → KR260; driver enabled only with LINK_OE_N low (OE in hardware: NAND of LINK_EN and LINK_TX_EN, ISO-11/ISO-15) | Proposed: before LINK_EN is high, HAT driver (74LVC244A, Ioff) in high impedance, no pull proposed | F12 (carrier schematic 038-05101-01 rev A02) sheet 12: J21 → HDC20, sheet 7: HDC20 → som240_2_a56; F13 (Kria_K26_SOM_Rev1.xdc): som240_2_a56 → W12 (IO_L11P_AD9P_44, bank 44); same as S1 (XDC Hackster 2022) and F11 (xczu5evsfvc784pkg.txt); allocation: rev. 0.4 proposal (preliminary schematic hardware/) | D14
39 | GND | none (GND) | — | — | — | Not applicable: GND (RPi pinout, S3) | Proposed: GND, connected to the HAT ground plane (ISO-03) | — | Proposed: not applicable (GND) | Proposed: GND always connected to the plane (ISO-03) | F12 (carrier schematic 038-05101-01 rev A02) sheet 12; same as S3 (standard Raspberry Pi pinout); allocation: rev. 0.4 proposal (preliminary schematic hardware/) | GND
40 | RPI_GPIO21_PCM_DOUT (HDC21) | none (direct to SOM240_2) | som240_2_a58 | W11 | Bank 44 (all 24 I/Os of the bank on J21, according to S1/F11); VCCO = PL_3V3 (VCCO_HDC, F12 sheet 7; bank VCCO pin som240_2_d59 in F13); I/O standard in S1: LVCMOS33 | PL (S1); IO_L11N_AD9N_44; RPi signal GPIO21; no HDGC | Proposed: LINK_D15 (bit order revisable during routing) | Proposed: GW1NR pin 57 (IOR13A/FASTRD_N/D3), bank 1, VCCIO1 3.3 V; via U132 1A1→1Y1, R147 22R | Proposed: HAT → KR260; driver enabled only with LINK_OE_N low (OE in hardware: NAND of LINK_EN and LINK_TX_EN, ISO-11/ISO-15) | Proposed: before LINK_EN is high, HAT driver (74LVC244A, Ioff) in high impedance, no pull proposed | F12 (carrier schematic 038-05101-01 rev A02) sheet 12: J21 → HDC21, sheet 7: HDC21 → som240_2_a58; F13 (Kria_K26_SOM_Rev1.xdc): som240_2_a58 → W11 (IO_L11N_AD9N_44, bank 44); same as S1 (XDC Hackster 2022) and F11 (xczu5evsfvc784pkg.txt); allocation: rev. 0.4 proposal (preliminary schematic hardware/) | D15
