calperxd/tangnano9k-kr260-hat/hardware/3d/tangnano9k-kr260-hat_rev0.4.step

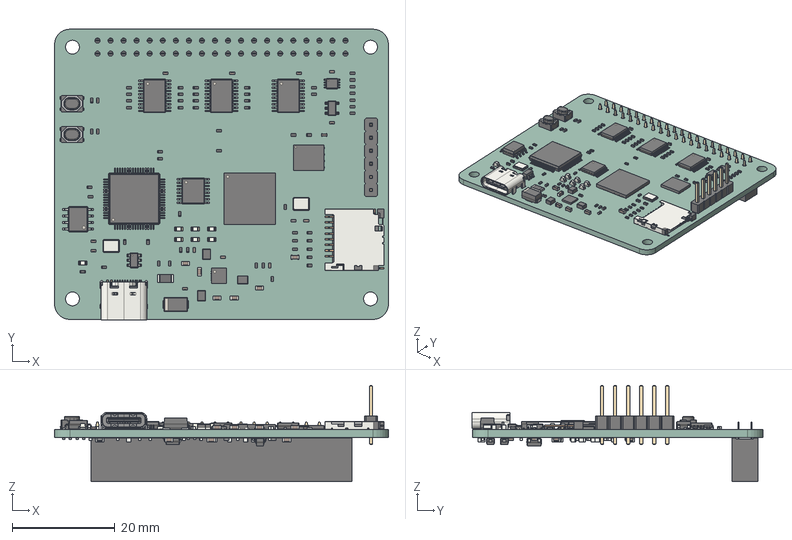
[picture p5: CAD file, 2026-10-21]
hardware/3d/tangnano9k-kr260-hat_rev0.4.step
65.0 x 56.6 x 18.7 mm
R_0402_1005Metric x 63
C_0402_1005Metric x 38
VSSOP-8_2.3x2mm_P0.5mm
microSD_HC_Hirose_DM3D-SF
TSSOP-20_4.4x6.5mm_P0.65mm x 3
ArtInChip_QFN-88-1EP_10x10mm_P0.4mm_EP6.74x6.74mm
C_0603_1608Metric x 24
LED_0603_1608Metric x 7
Fuse_1206_3216Metric
L_0402_1005Metric x 7
PinHeader_1x06_P254mm_Vertical
UQFN-20-1EP_3x3mm_Pitch0.4mm
WSON-8-1EP_6x5mm_P1.27mm_EP3.4x4.3mm
SOT-23-6
USB_C_Receptacle_16P_TopMnt_Horizontal_GCT_USB4105-xx-A
L_Murata_DFE201610P x 3
Crystal_SMD_3225-4Pin_3.2x2.5mm x 2
SOIC-8_3.9x4.9mm_P1.27mm
TSSOP-16_4.4x5mm_P0.65mm
SOT-23-5 x 2
LQFP-64_10x10mm_P0.5mm
SW_SPST_PTS810 x 2
D_SMA
D_SOD-123 x 2
PinSocket_2x20_P2.54mm_Vertical
tangnano9k-kr260-hat_PCB
