calperxd/tangnano9k-kr260-hat/hardware/tangnano9k-kr260-hat_schematic_rev0.4.pdf

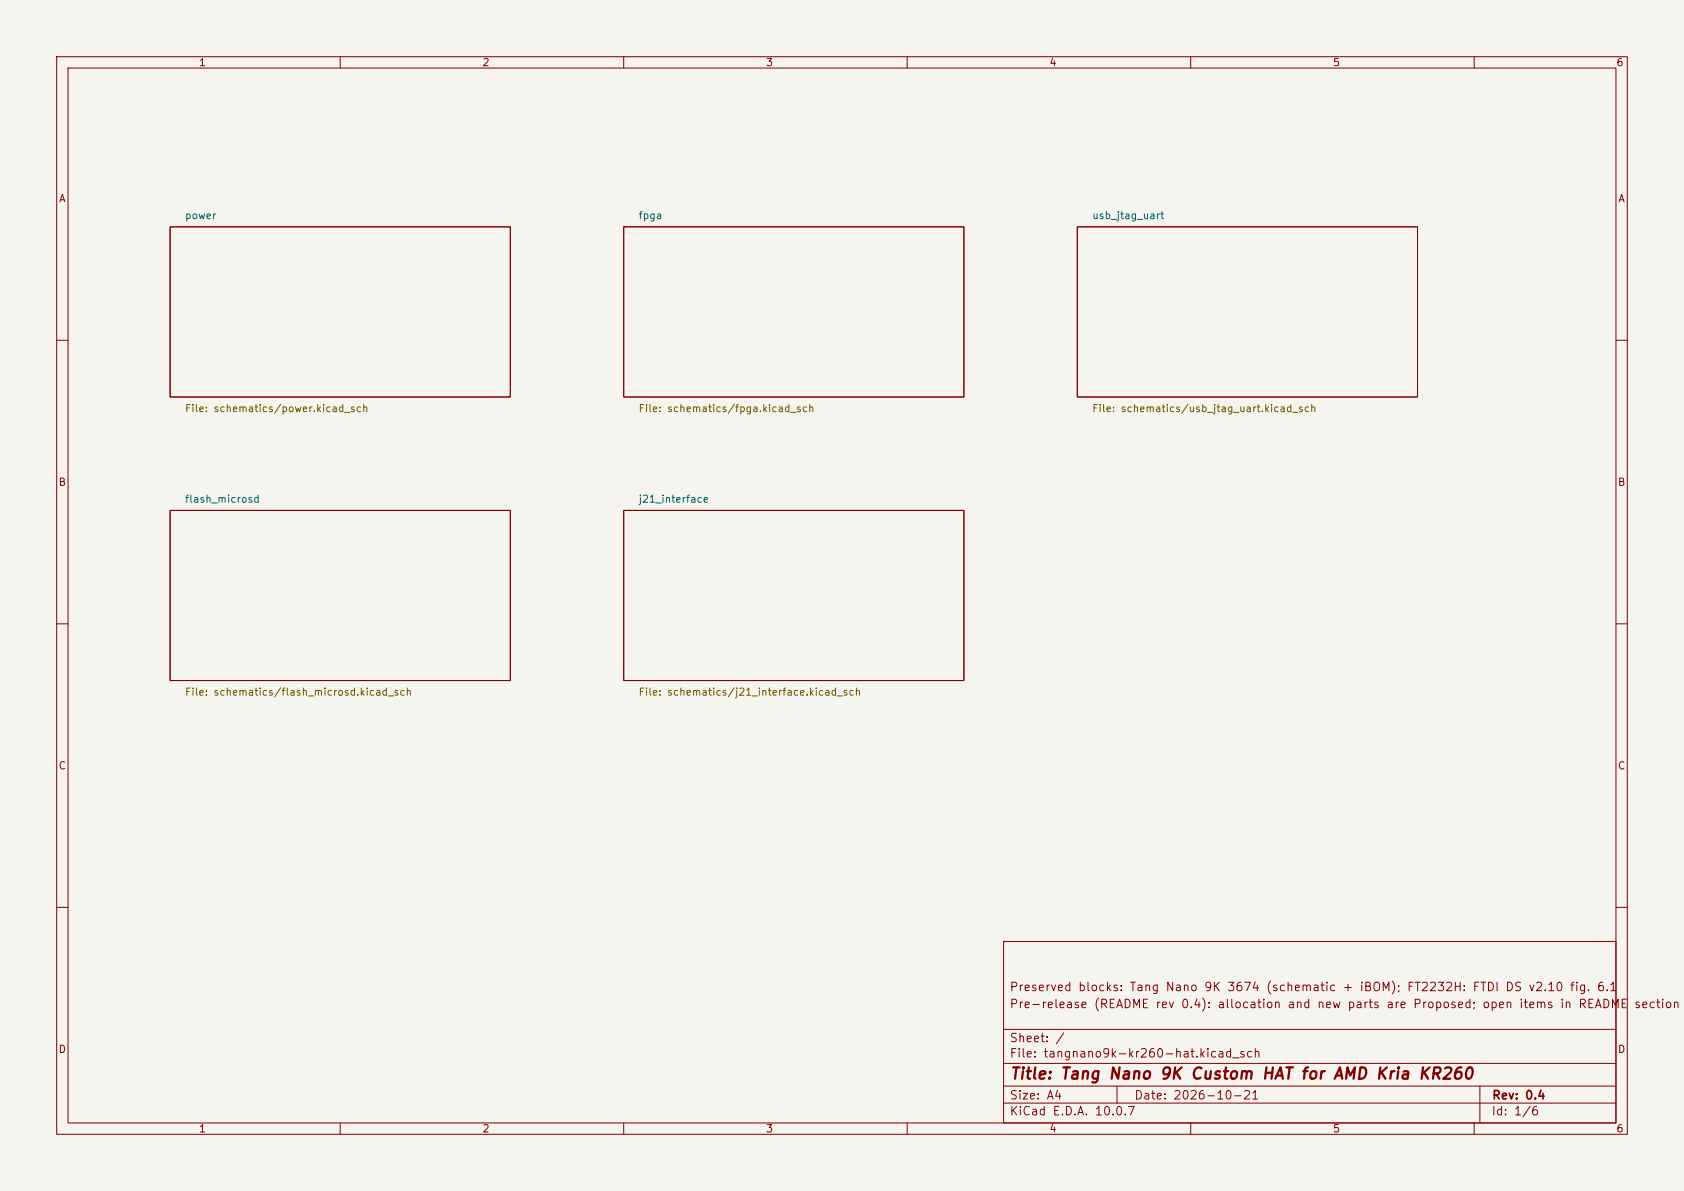
[picture p6: page 1]

power File: schematics/power.kicad_sch

Preserved blocks: Tang Nano 9K 3674 (schematic + iBOM); FT2232H: FTDI DS v2.10 fig. 6.1
Pre-release (README rev 0.4): allocation and new parts are Proposed; open items in README section 20

Sheet: /
File: tangnano9k-kr260-hat.kicad_sch
Title: Tang Nano 9K Custom HAT for AMD Kria KR260

Size: A4 | Rev: 0.4
KiCad E.D.A. 10.0.7 | Id: 1/6

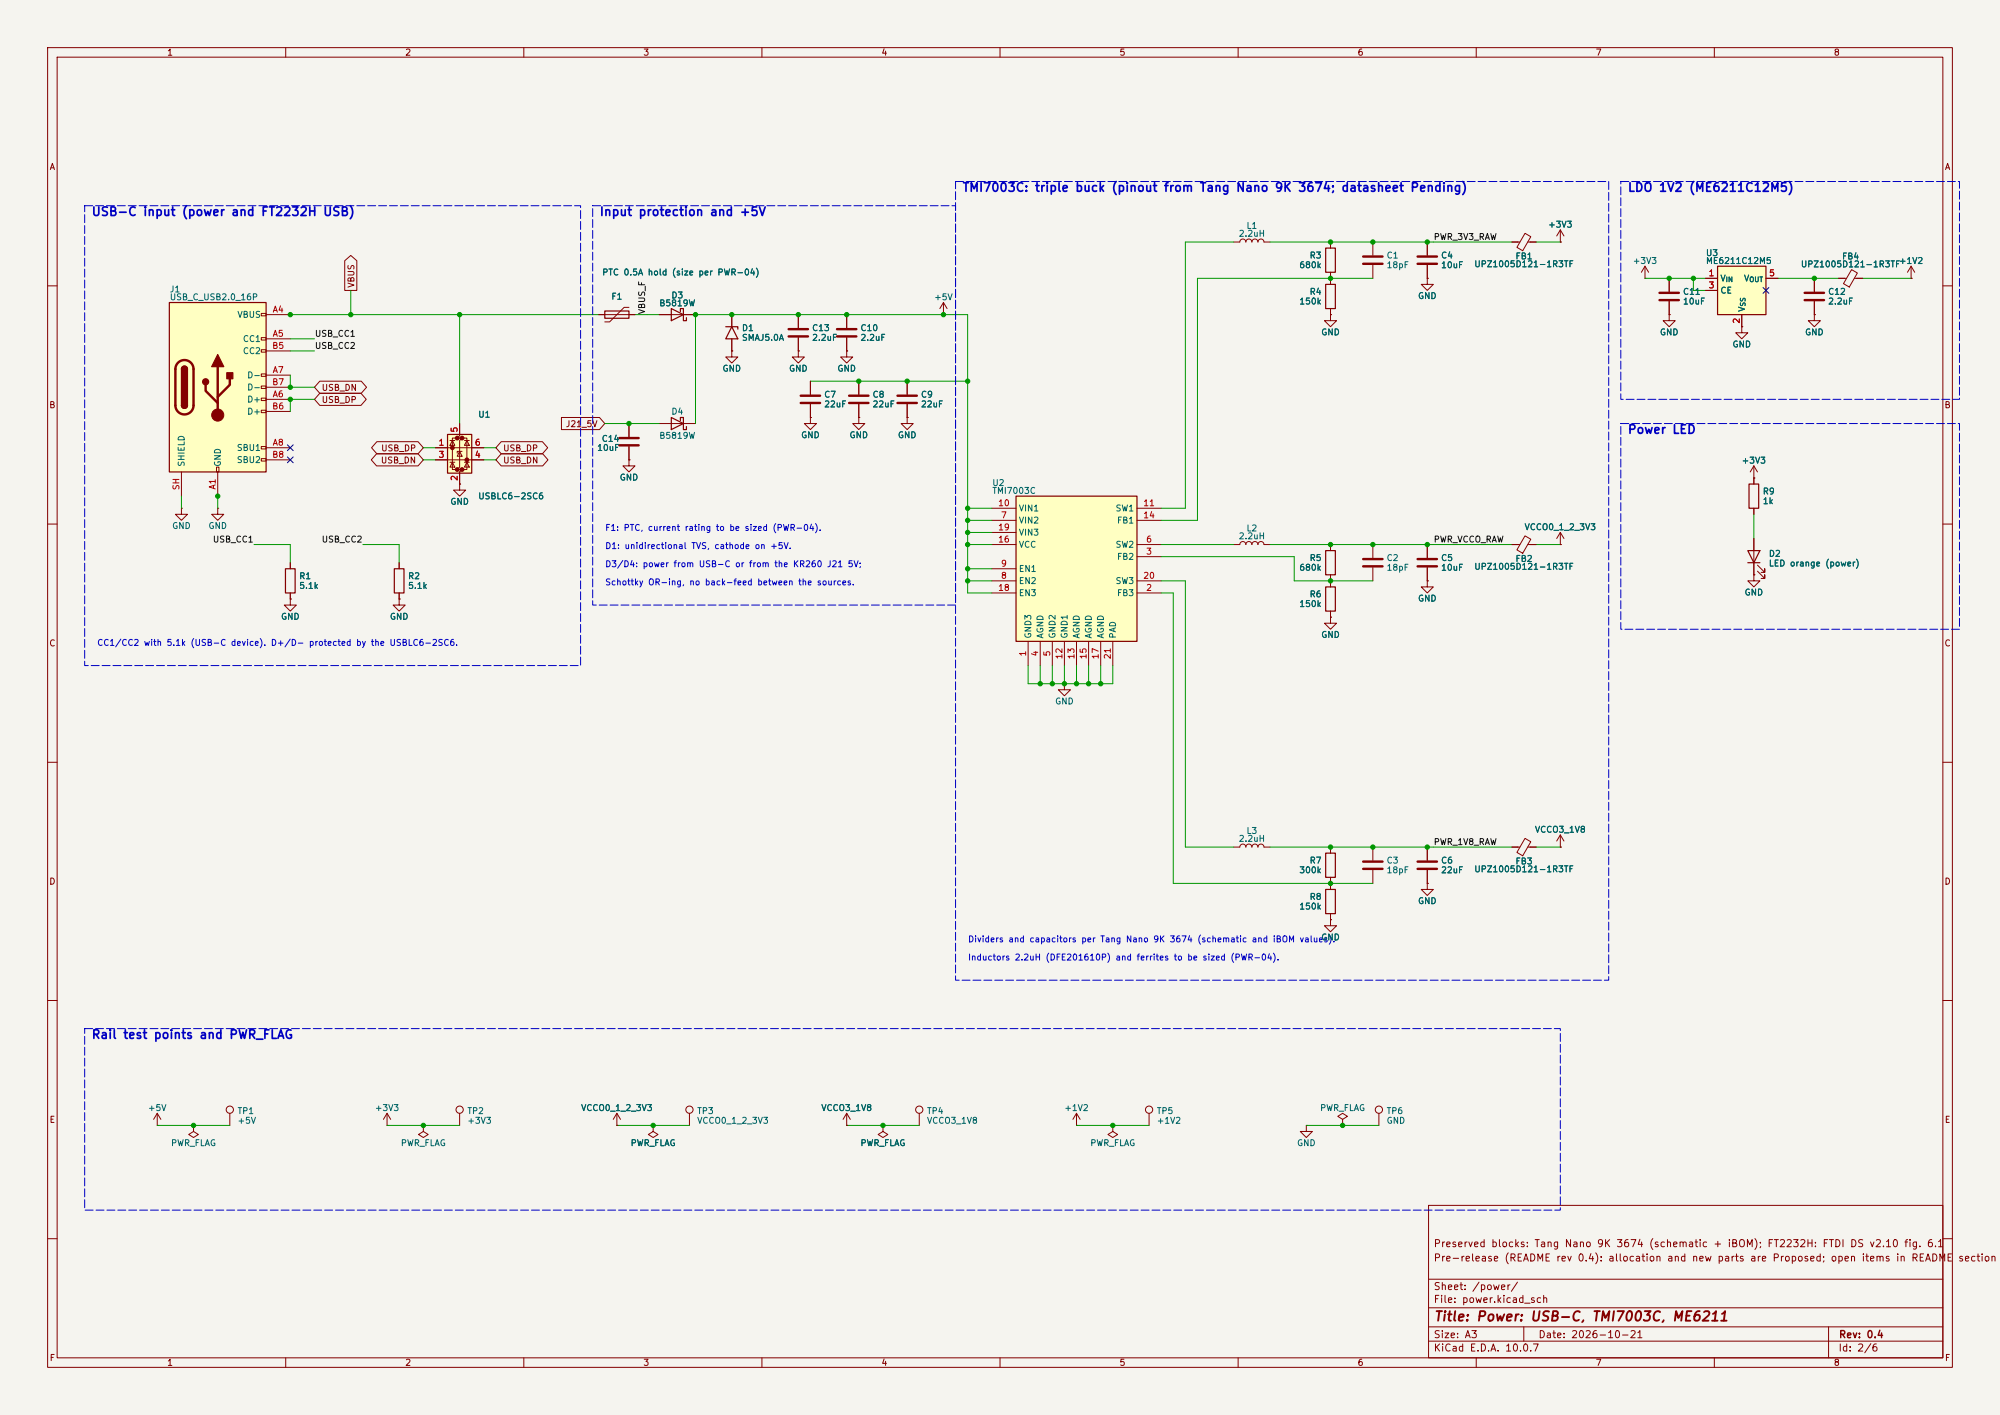
[picture p7: page 2]

USB-C input (power and FT2232H USB)

F1 PTC 0.5A hold (size per PWR-04) C14

F1: PTC, current rating to be sized (PWR-04).

LED orange (power) GND

Inductors 2.2uH (DFE201610P) and ferrites to be sized (PWR-04).

Rail test points and PWR_FLAG

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

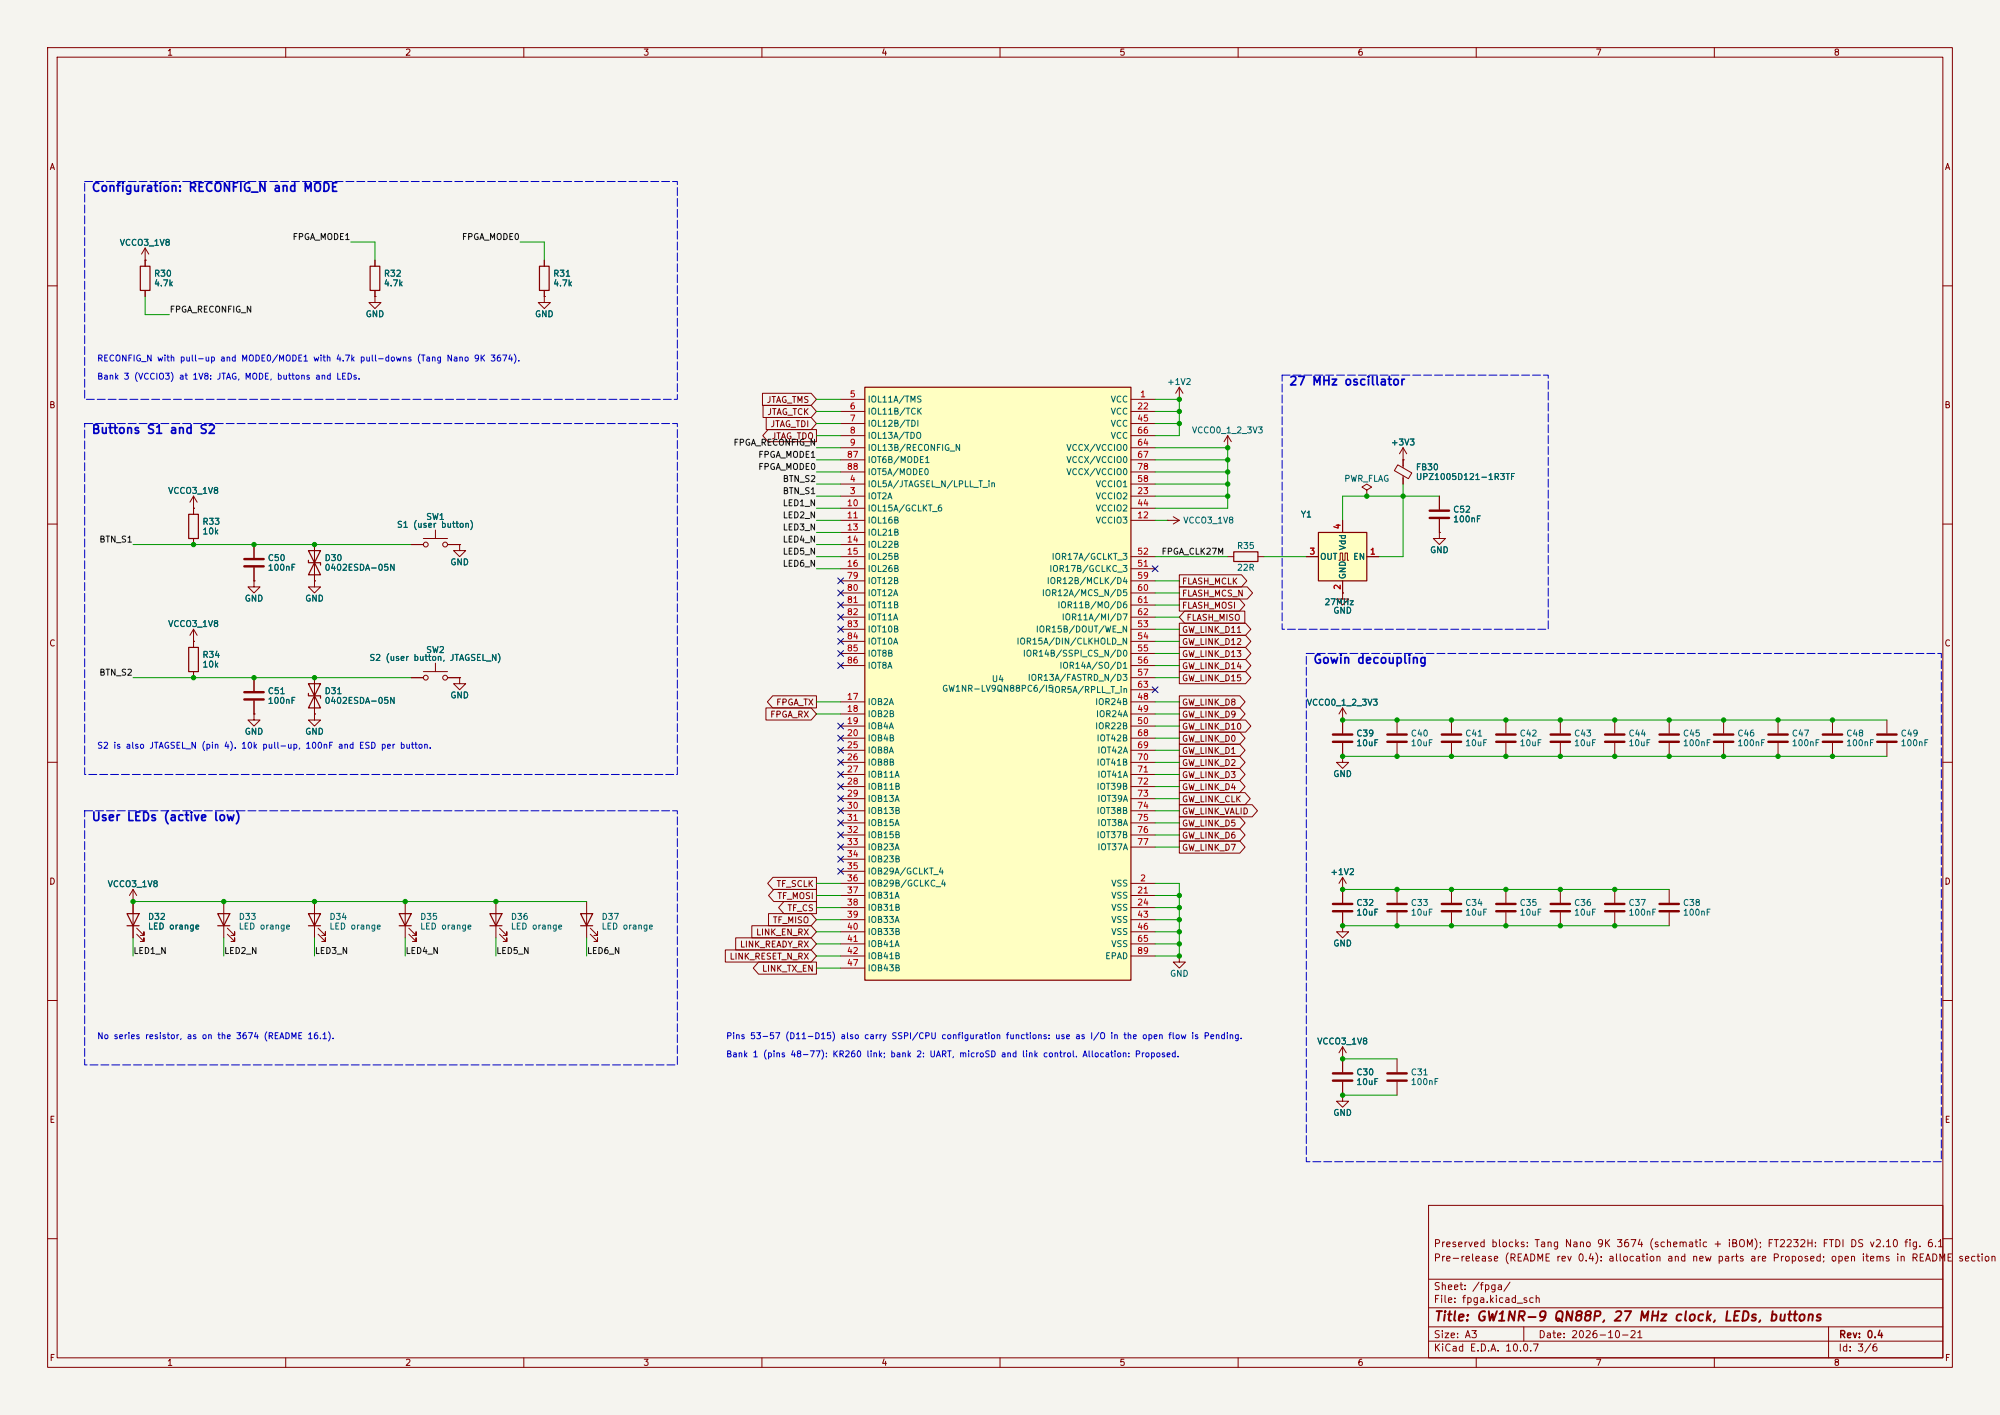
[picture p8: page 3]

FPGA_MODE0 User LEDs (active low)

No series resistor, as on the 3674 (README 16.1).

Bank 1 (pins 48-77): KR260 link; bank 2: UART, microSD and link control. Allocation: Proposed. Pins 53-57 (D11-D15) also carry SSPI/CPU configuration functions: use as I/O in the open flow is Pending.

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

Sheet: /fpga/
File: fpga.kicad_sch
Title: GW1NR-9 QN88P, 27 MHz clock, LEDs, buttons

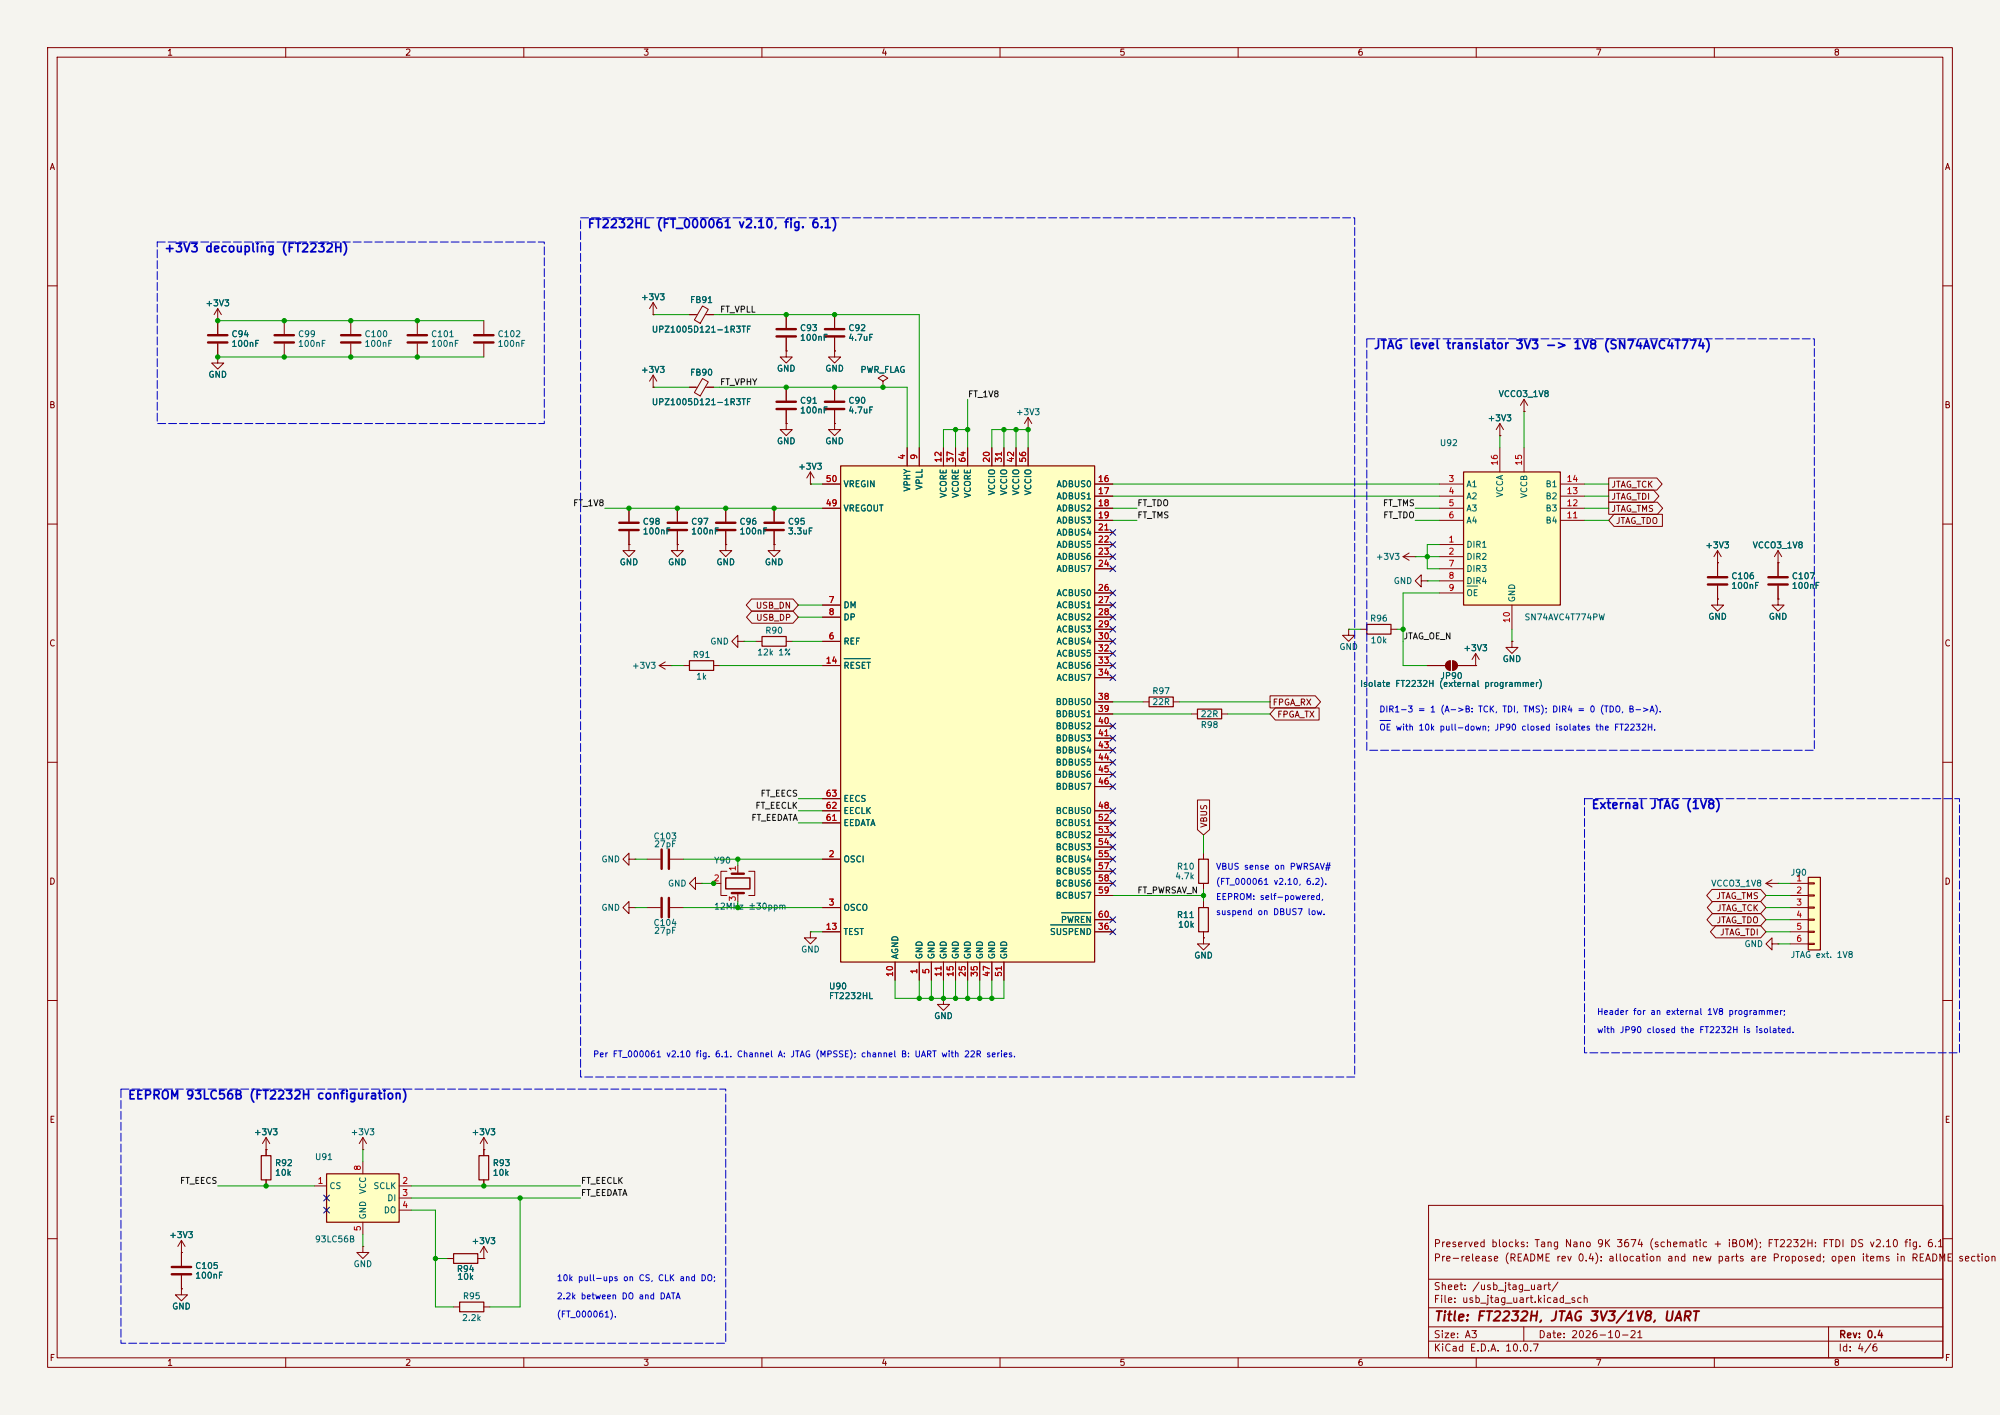
[picture p9: page 4]

5 REF 6 DM 7 DP 8 VPLL 9 AGND 10 GND 11 VCORE 12

1 OSCI 2 OSCO 3 VPHY 4 GND

(FT_000061 v2.10, 6.2). VBUS sense on PWRSAV#

with JP90 closed the FT2232H is isolated. Header for an external 1V8 programmer; (FT_000061).

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

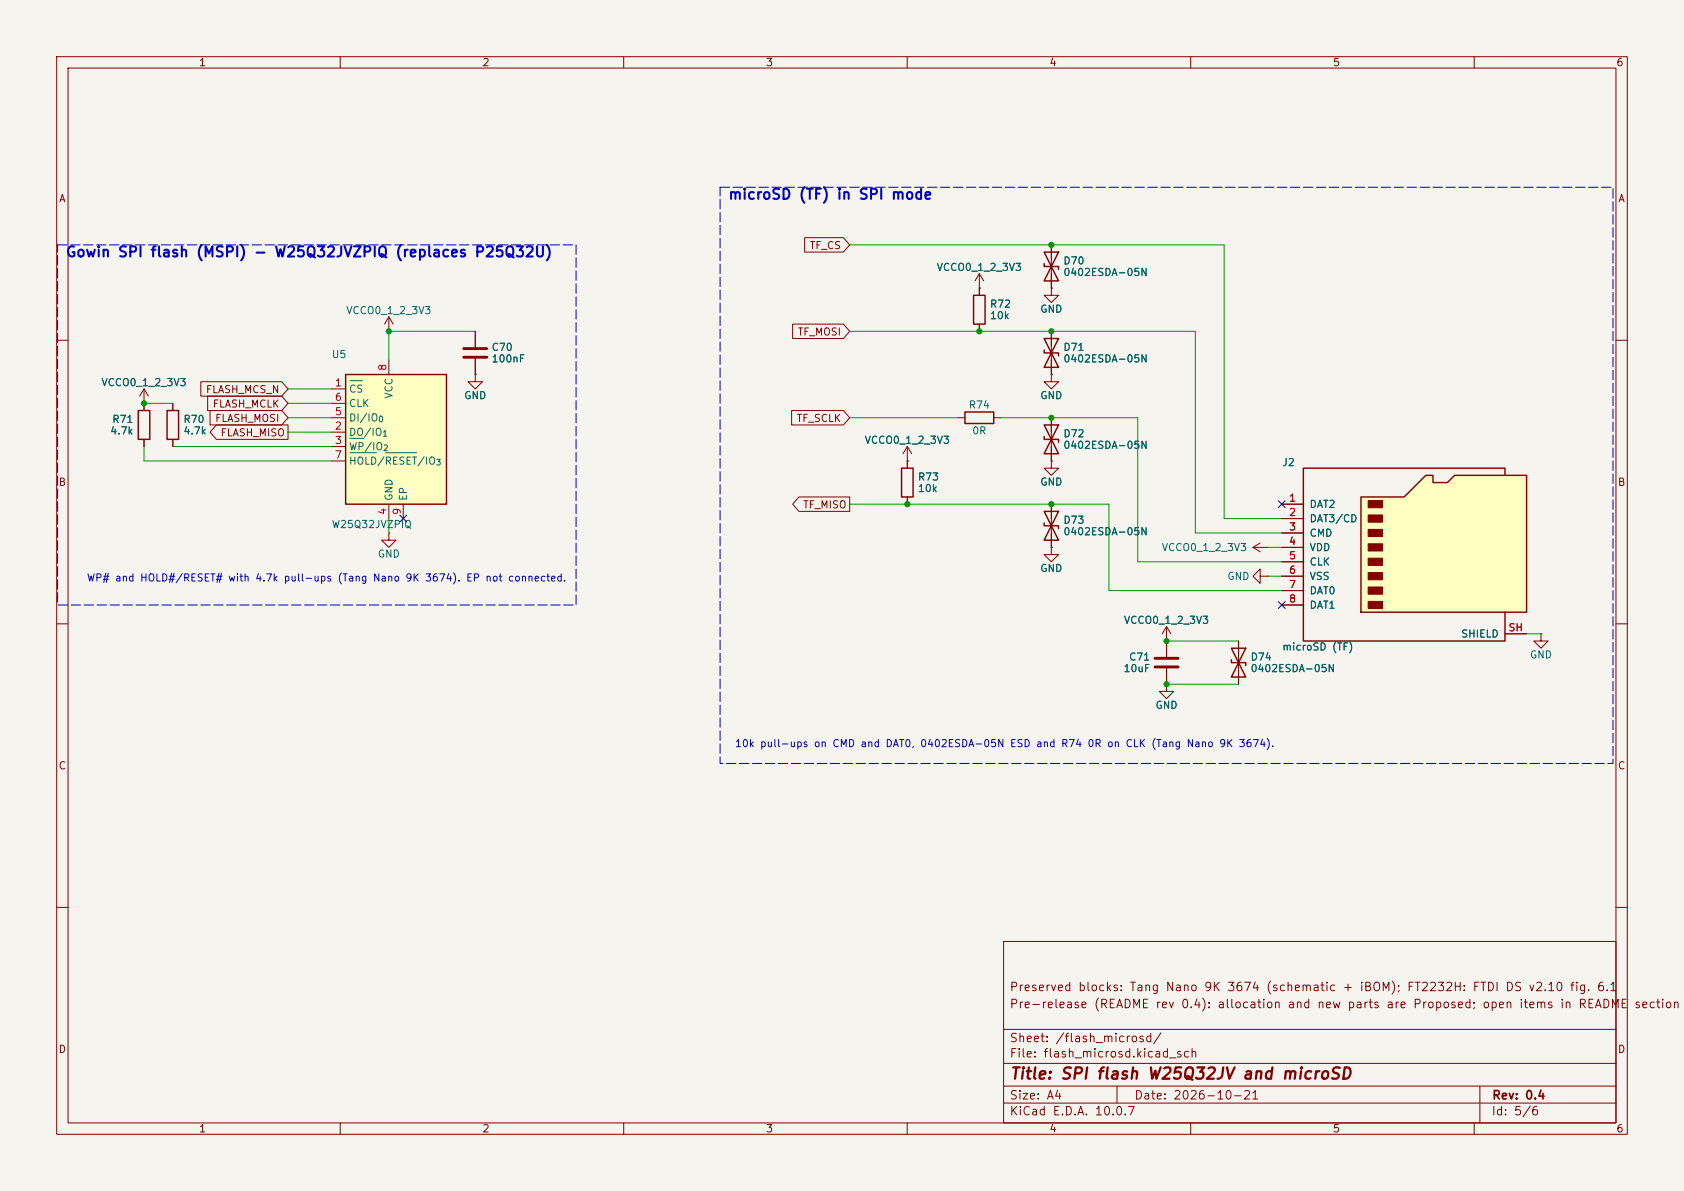
[picture p10: page 5]

TF_SCLK microSD (TF) in SPI mode
10uF GND

WP# and HOLD#/RESET# with 4.7k pull-ups (Tang Nano 9K 3674). EP not connected. C70

4 DI/IO0 5 CLK 6 HOLD/RESET/IO3 7 VCC

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

Sheet: /flash_microsd/
File: flash_microsd.kicad_sch
Title: SPI flash W25Q32JV and microSD

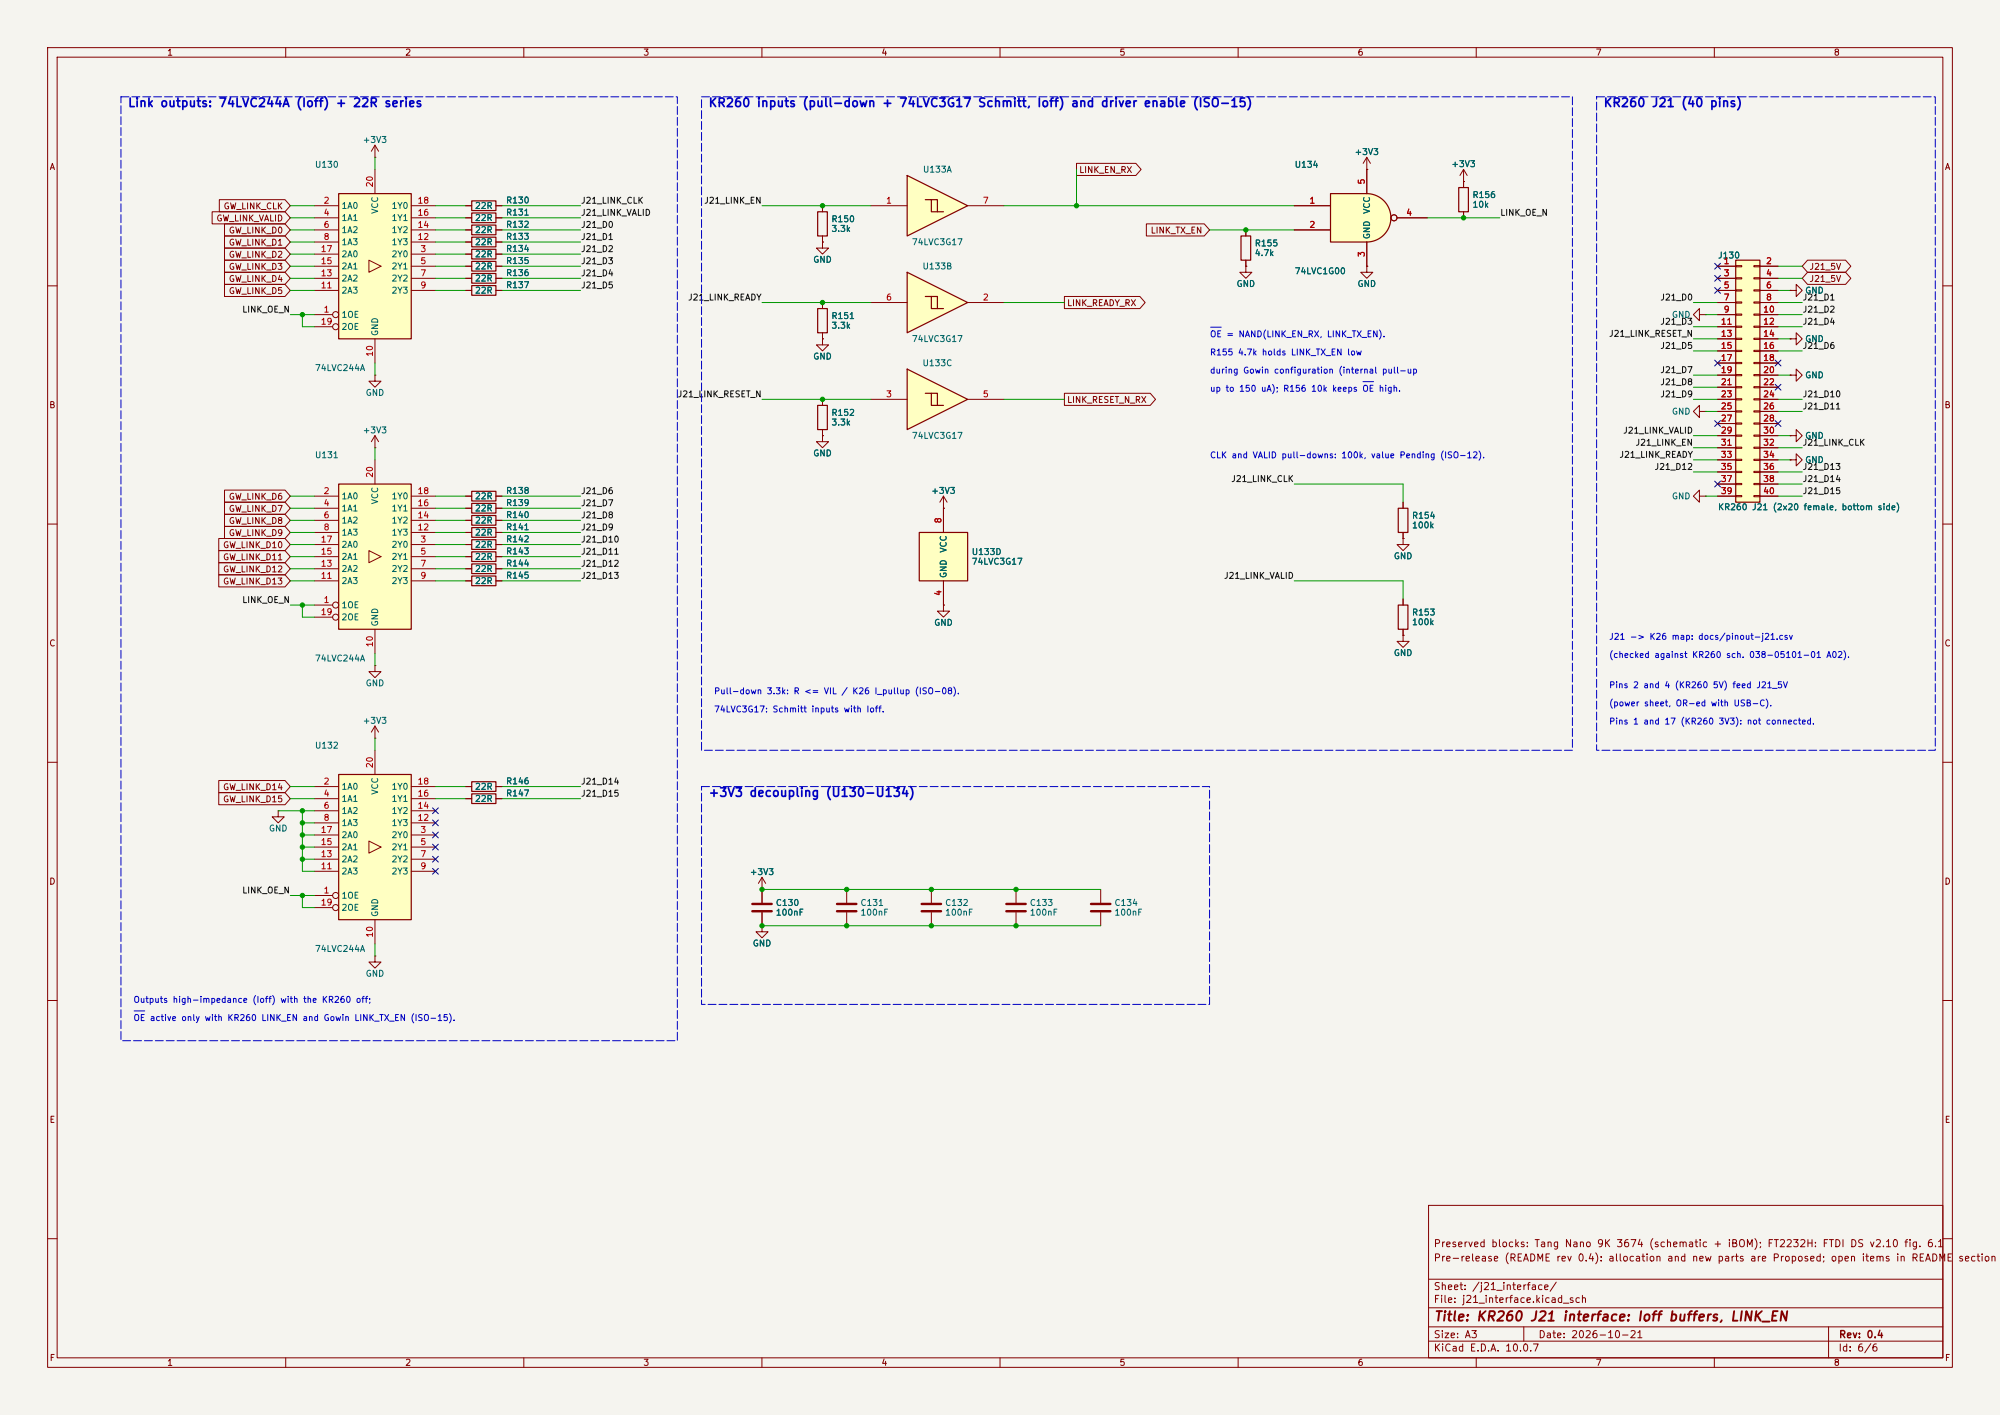
[picture p11: page 6]

Link outputs: 74LVC244A (Ioff) + 22R series

KR260 inputs (pull-down + 74LVC3G17 Schmitt, Ioff) and driver enable (ISO-15)

J130 KR260 J21 (2x20 female, bottom side) GND +3V3 GND

during Gowin configuration (internal pull-up

up to 150 uA); R156 10k keeps OE high. OE active only with KR260 LINK_EN and Gowin LINK_TX_EN (ISO-15).

(checked against KR260 sch. 038-05101-01 A02). J21 -> K26 map: docs/pinout-j21.csv

74LVC3G17: Schmitt inputs with Ioff. Pull-down 3.3k: R <= VIL / K26 I_pullup (ISO-08).

(power sheet, OR-ed with USB-C). Pins 1 and 17 (KR260 3V3): not connected.

Outputs high-impedance (Ioff) with the KR260 off;

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

Sheet: /j21_interface/
File: j21_interface.kicad_sch
Title: KR260 J21 interface: Ioff buffers, LINK_EN
