calperxd/tangnano9k-kr260-hat/hardware/production/fit_template_1to1.pdf

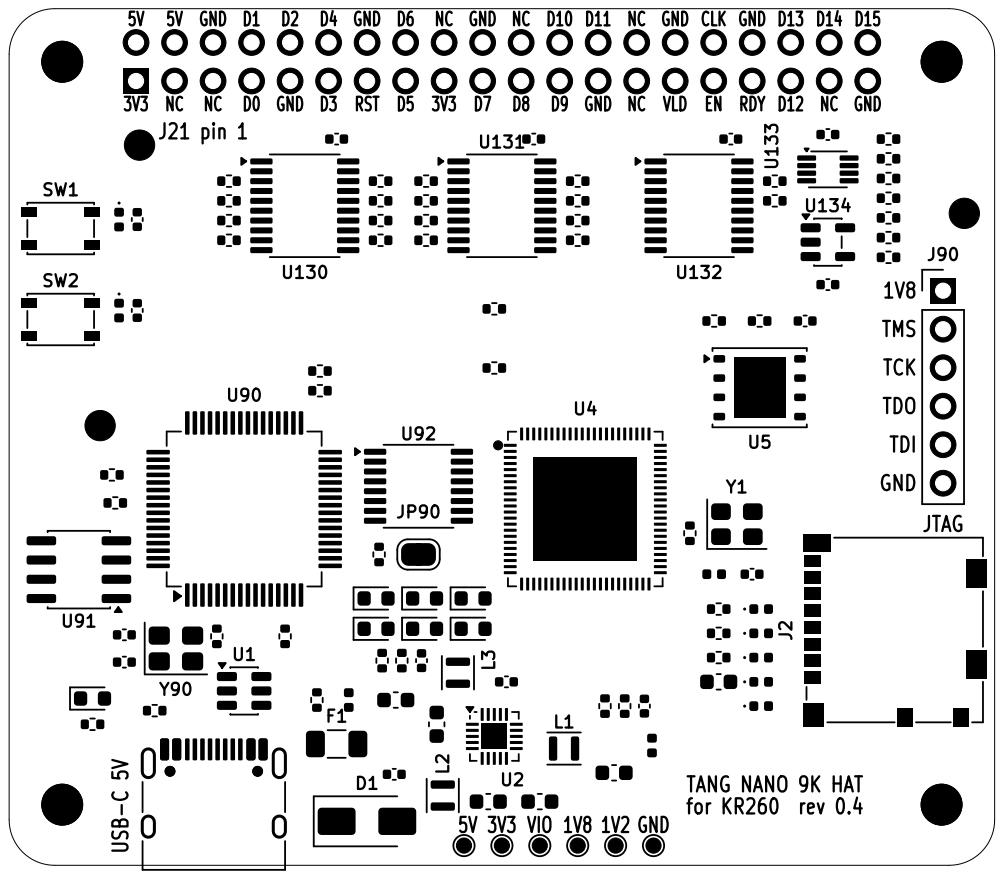
[picture p12: page 1]
