calperxd/tangnano9k-kr260-hat/hardware/tangnano9k-kr260-hat.kicad_pcb

## KiCad design hardware/tangnano9k-kr260-hat.kicad_pcb (2026-11-03)

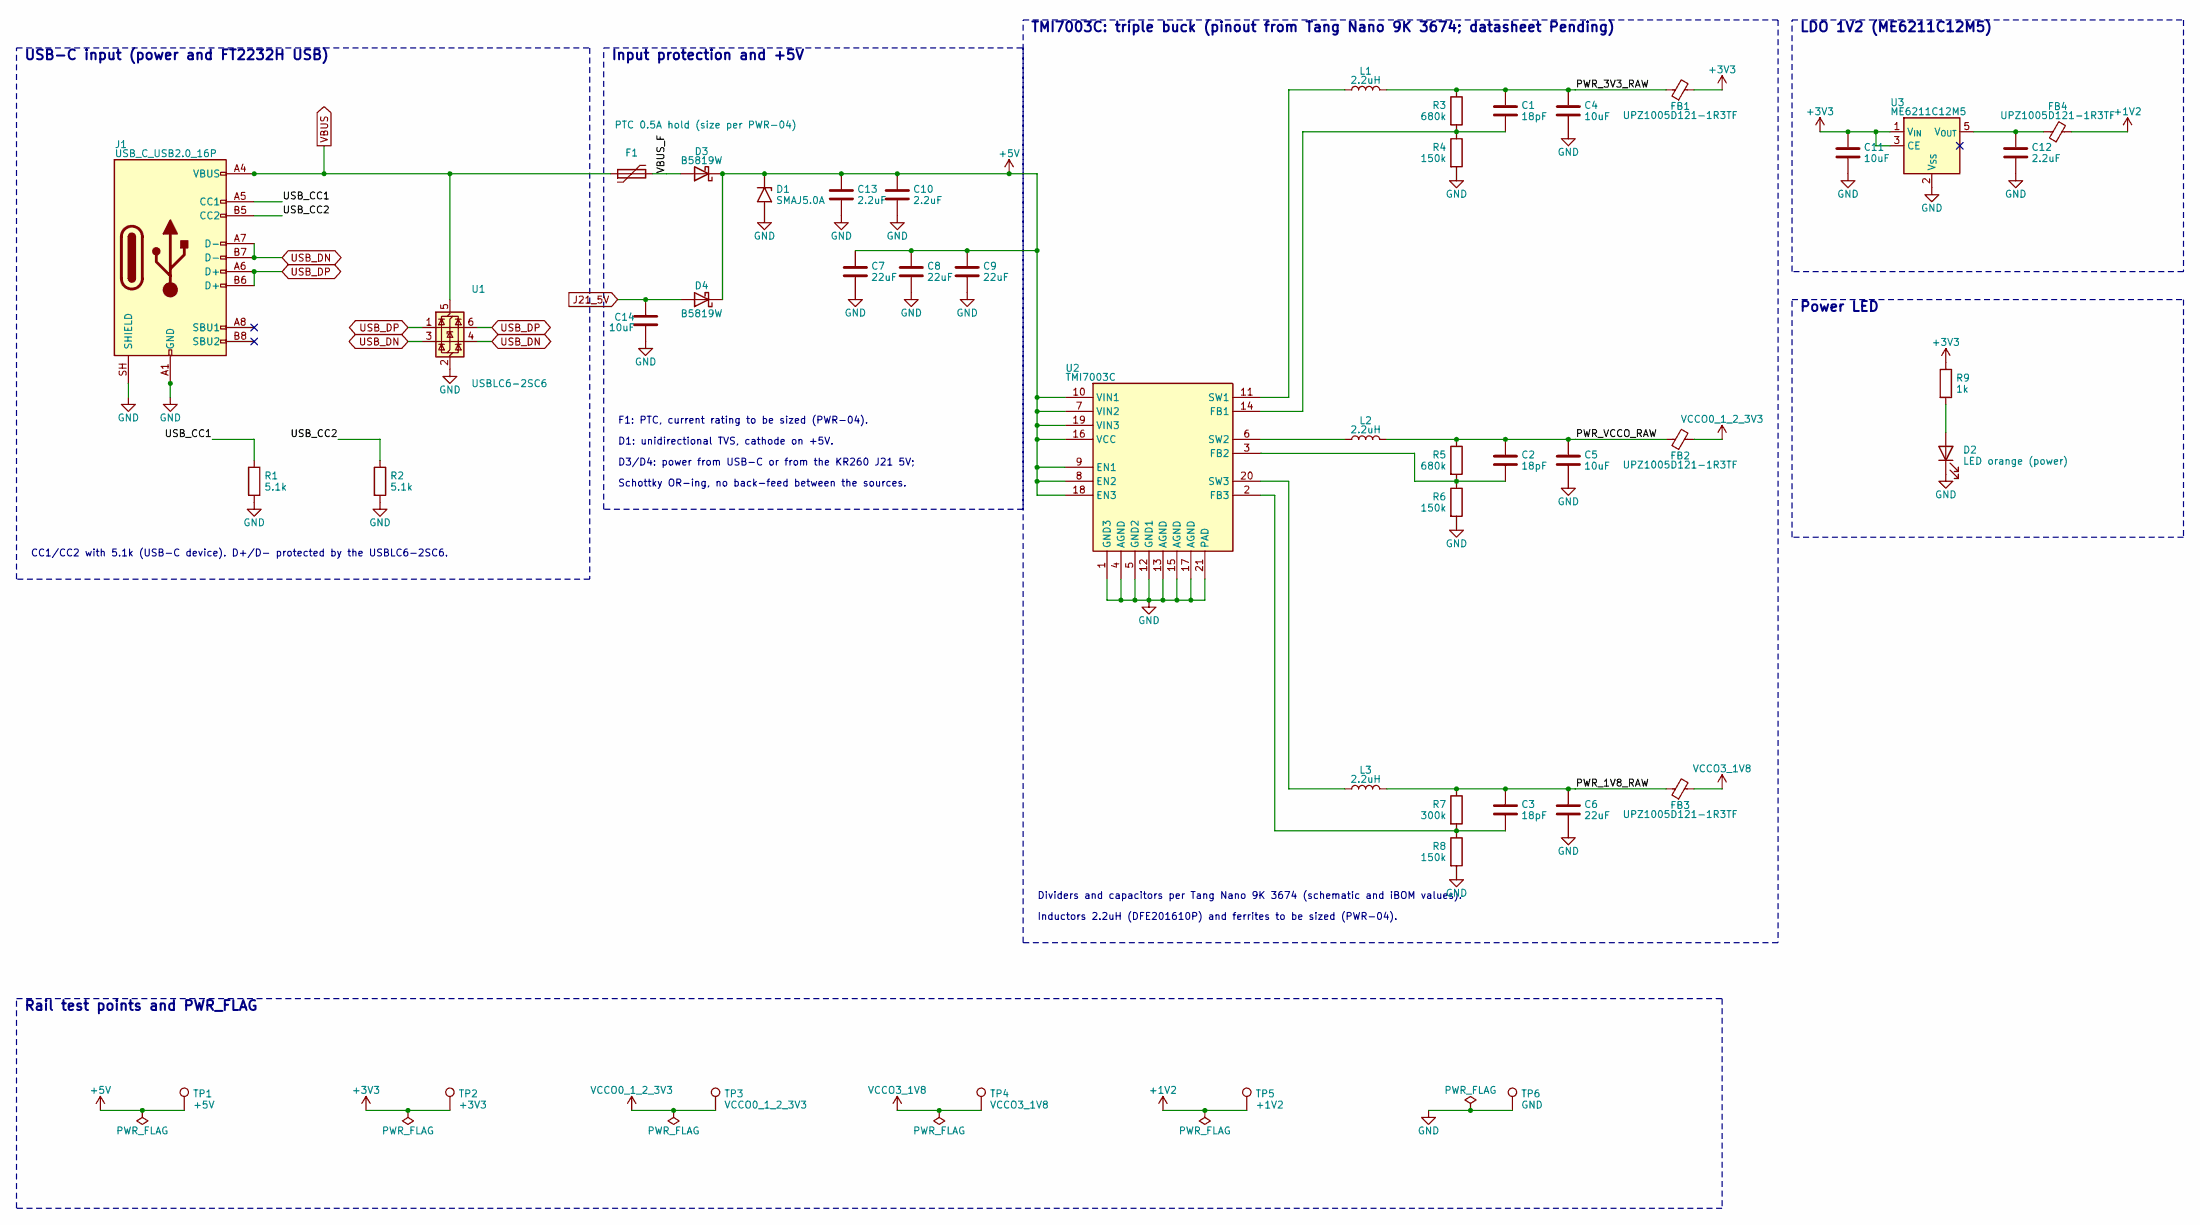
[picture p13: schematic power.kicad_sch, Power: USB-C, TMI7003C, ME6211]

Parts:
C1, C2, C3: 18pF; C_0402_1005Metric
C4, C5, C11, C14: 10uF; C_0603_1608Metric
C6, C7, C8, C9: 22uF; C_0603_1608Metric
C10, C12, C13: 2.2uF; C_0402_1005Metric
D1: SMAJ5.0A; D_SMA
D2: LED orange (power); LED_0603_1608Metric
D3, D4: B5819W; D_SOD-123
F1: PTC 0.5A hold (size per PWR-04); Fuse_1206_3216Metric
FB1, FB2, FB3, FB4: UPZ1005D121-1R3TF; L_0402_1005Metric
J1: USB_C_USB2.0_16P; USB_C_Receptacle_HRO_TYPE-C-31-M-12
L1, L2, L3: 2.2uH; L_Murata_DFE201610P
R1, R2: 5.1k; R_0402_1005Metric
R3, R5: 680k; R_0402_1005Metric
R4, R6, R8: 150k; R_0402_1005Metric
R7: 300k; R_0402_1005Metric
R9: 1k; R_0402_1005Metric
TP1: +5V; TestPoint_Pad_D1.0mm
TP2: +3V3; TestPoint_Pad_D1.0mm
TP3: VCCO0_1_2_3V3; TestPoint_Pad_D1.0mm
TP4: VCCO3_1V8; TestPoint_Pad_D1.0mm
TP5: +1V2; TestPoint_Pad_D1.0mm
TP6: GND; TestPoint_Pad_D1.0mm
U1: USBLC6-2SC6; SOT-23-6
U2: TMI7003C; QFN-20-1EP_3x3mm_P0.4mm_EP1.65x1.65mm
U3: ME6211C12M5; SOT-23-5

Connections:
+1V2: FB4.2, TP5.1; also elsewhere on the board
+3V3: C11.1, FB1.2, R9.1, TP2.1, U3.1 (V_{IN}), U3.3 (CE); also elsewhere on the board
+5V: C7.1, C8.1, C9.1, C10.1, C13.1, D1.1 (A1), D3.1 (K), D4.1 (K), TP1.1, U2.7 (VIN2), U2.8 (EN2), U2.9 (EN1), U2.10 (VIN1), U2.16 (VCC), U2.18 (EN3), U2.19 (VIN3)
/power/PWR_1V8_RAW: C3.1, C6.1, FB3.1, L3.2, R7.1
/power/PWR_3V3_RAW: C1.1, C4.1, FB1.1, L1.2, R3.1
/power/PWR_VCCO_RAW: C2.1, C5.1, FB2.1, L2.2, R5.1
/power/USB_CC1: J1.A5 (CC1), R1.1
/power/USB_CC2: J1.B5 (CC2), R2.1
/power/VBUS_F: D3.2 (A), F1.2
GND: C4.2, C5.2, C6.2, C7.2, C8.2, C9.2, C10.2, C11.2, C12.2, C13.2, C14.2, D1.2 (A2), D2.1 (K), J1.A1 (GND), J1.A12 (GND), J1.B1 (GND), J1.B12 (GND), J1.SH (SHIELD), R1.2, R2.2, R4.2, R6.2, R8.2, TP6.1, U1.2 (GND), U2.1 (GND3), U2.4 (AGND), U2.5 (GND2), U2.12 (GND1), U2.13 (AGND), U2.15 (AGND), U2.17 (AGND), U2.21 (PAD), U3.2 (V_{SS}); also elsewhere on the board
J21_5V: C14.1, D4.2 (A); also elsewhere on the board
unnamed: D2.2 (A), R9.2
unnamed: C1.2, R3.2, R4.1, U2.14 (FB1)
unnamed: C2.2, R5.2, R6.1, U2.3 (FB2)
unnamed: C3.2, R7.2, R8.1, U2.2 (FB3)
unnamed: L1.1, U2.11 (SW1)
unnamed: L2.1, U2.6 (SW2)
unnamed: L3.1, U2.20 (SW3)
unnamed: C12.1, FB4.1, U3.5 (V_{OUT})
USB_DN: J1.A7 (D-), J1.B7 (D-), U1.3 (I/O2), U1.4 (I/O2); also elsewhere on the board
USB_DP: J1.A6 (D+), J1.B6 (D+), U1.1 (I/O1), U1.6 (I/O1); also elsewhere on the board
VBUS: F1.1, J1.A4 (VBUS), J1.A9 (VBUS), J1.B4 (VBUS), J1.B9 (VBUS), U1.5 (VBUS); also elsewhere on the board
VCCO0_1_2_3V3: FB2.2, TP3.1; also elsewhere on the board
VCCO3_1V8: FB3.2, TP4.1; also elsewhere on the board

Notes on the sheet:
USB-C input (power and FT2232H USB)
CC1/CC2 with 5.1k (USB-C device). D+/D- protected by the USBLC6-2SC6.
Input protection and +5V
F1: PTC, current rating to be sized (PWR-04).
D1: unidirectional TVS, cathode on +5V.
D3/D4: power from USB-C or from the KR260 J21 5V;
Schottky OR-ing, no back-feed between the sources.
TMI7003C: triple buck (pinout from Tang Nano 9K 3674; datasheet Pending)
Dividers and capacitors per Tang Nano 9K 3674 (schematic and iBOM values).
Inductors 2.2uH (DFE201610P) and ferrites to be sized (PWR-04).
LDO 1V2 (ME6211C12M5)
Power LED
Rail test points and PWR_FLAG

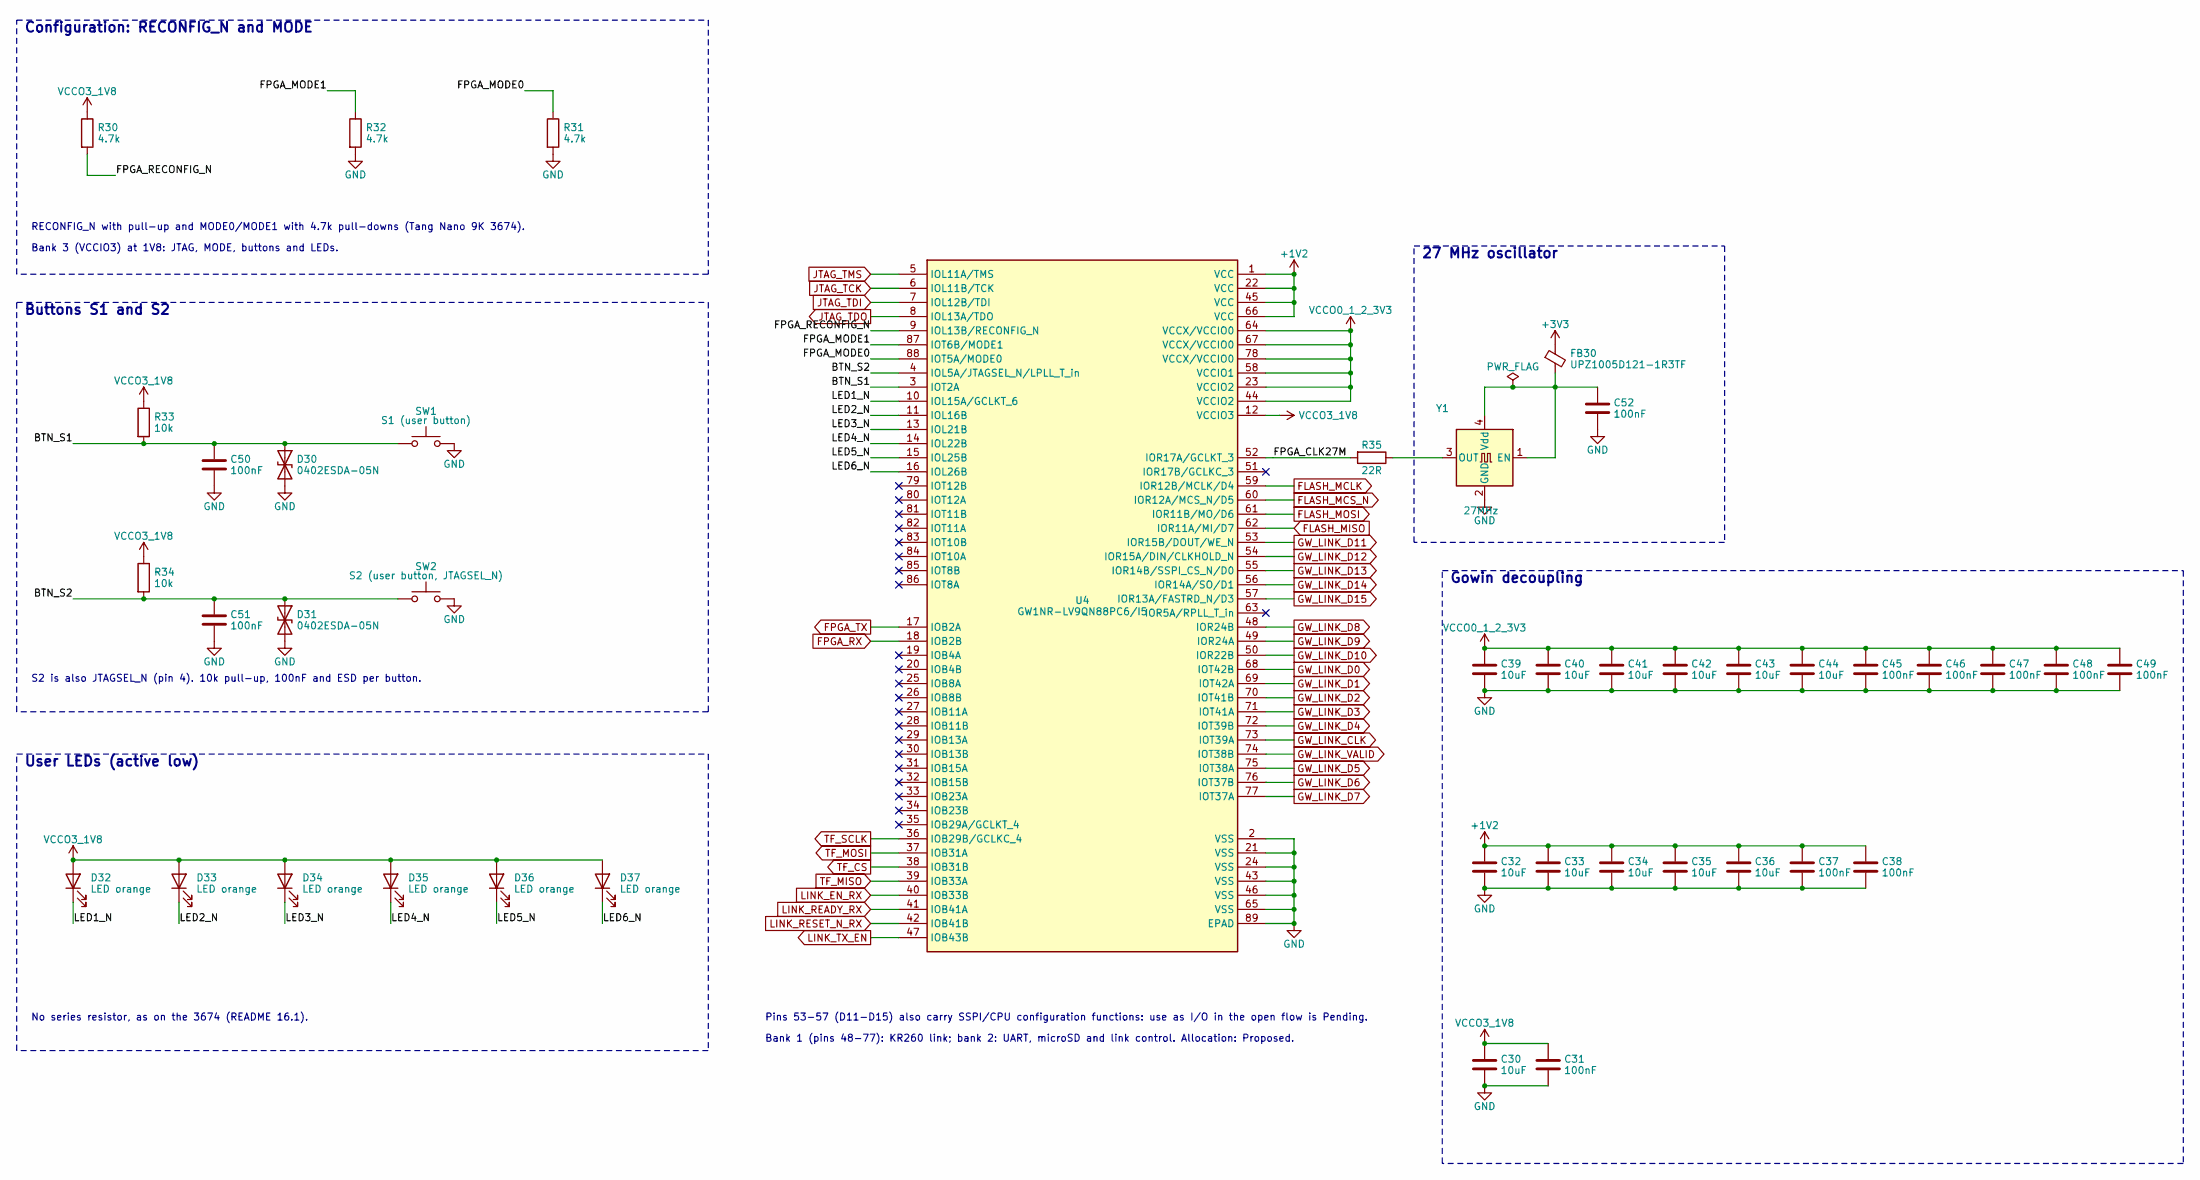
[picture p14: schematic fpga.kicad_sch, GW1NR-9 QN88P, 27 MHz clock, LEDs, buttons]

Parts:
C30, C32, C33, C34, C35, C36, C39, C40, C41, C42, C43, C44: 10uF; C_0603_1608Metric
C31, C37, C38, C45, C46, C47, C48, C49, C50, C51, C52: 100nF; C_0402_1005Metric
D30, D31: 0402ESDA-05N; D_0402_1005Metric
D32, D33, D34, D35, D36, D37: LED orange; LED_0603_1608Metric
FB30: UPZ1005D121-1R3TF; L_0402_1005Metric
R30, R31, R32: 4.7k; R_0402_1005Metric
R33, R34: 10k; R_0402_1005Metric
R35: 22R; R_0402_1005Metric
SW1: S1 (user button); SW_SPST_PTS810
SW2: S2 (user button, JTAGSEL_N); SW_SPST_PTS810
U4: GW1NR-LV9QN88PC6/I5; GW1NR_QN88P_10x10mm_P0.4mm_EP6.8mm
Y1: 27MHz; Oscillator_SMD_Abracon_ASE-4Pin_3.2x2.5mm

Connections:
+1V2: C32.1, C33.1, C34.1, C35.1, C36.1, C37.1, C38.1, U4.1 (VCC), U4.22 (VCC), U4.45 (VCC), U4.66 (VCC); also elsewhere on the board
+3V3: FB30.1; also elsewhere on the board
/fpga/BTN_S1: C50.1, D30.1 (A1), R33.2, SW1.1, U4.3 (IOT2A)
/fpga/BTN_S2: C51.1, D31.1 (A1), R34.2, SW2.1, U4.4 (IOL5A/JTAGSEL_N/LPLL_T_in)
/fpga/FPGA_CLK27M: R35.2, U4.52 (IOR17A/GCLKT_3)
/fpga/FPGA_MODE0: R31.1, U4.88 (IOT5A/MODE0)
/fpga/FPGA_MODE1: R32.1, U4.87 (IOT6B/MODE1)
/fpga/FPGA_RECONFIG_N: R30.2, U4.9 (IOL13B/RECONFIG_N)
/fpga/LED1_N: D32.1 (K), U4.10 (IOL15A/GCLKT_6)
/fpga/LED2_N: D33.1 (K), U4.11 (IOL16B)
/fpga/LED3_N: D34.1 (K), U4.13 (IOL21B)
/fpga/LED4_N: D35.1 (K), U4.14 (IOL22B)
/fpga/LED5_N: D36.1 (K), U4.15 (IOL25B)
/fpga/LED6_N: D37.1 (K), U4.16 (IOL26B)
FLASH_MCLK: U4.59 (IOR12B/MCLK/D4); also elsewhere on the board
FLASH_MCS_N: U4.60 (IOR12A/MCS_N/D5); also elsewhere on the board
FLASH_MISO: U4.62 (IOR11A/MI/D7); also elsewhere on the board
FLASH_MOSI: U4.61 (IOR11B/MO/D6); also elsewhere on the board
FPGA_RX: U4.18 (IOB2B); also elsewhere on the board
FPGA_TX: U4.17 (IOB2A); also elsewhere on the board
GND: C30.2, C31.2, C32.2, C33.2, C34.2, C35.2, C36.2, C37.2, C38.2, C39.2, C40.2, C41.2, C42.2, C43.2, C44.2, C45.2, C46.2, C47.2, C48.2, C49.2, C50.2, C51.2, C52.2, D30.2 (A2), D31.2 (A2), R31.2, R32.2, SW1.2, SW2.2, U4.2 (VSS), U4.21 (VSS), U4.24 (VSS), U4.43 (VSS), U4.46 (VSS), U4.65 (VSS), U4.89 (EPAD), Y1.2 (GND); also elsewhere on the board
GW_LINK_CLK: U4.73 (IOT39A); also elsewhere on the board
GW_LINK_D0: U4.68 (IOT42B); also elsewhere on the board
GW_LINK_D1: U4.69 (IOT42A); also elsewhere on the board
GW_LINK_D2: U4.70 (IOT41B); also elsewhere on the board
GW_LINK_D3: U4.71 (IOT41A); also elsewhere on the board
GW_LINK_D4: U4.72 (IOT39B); also elsewhere on the board
GW_LINK_D5: U4.75 (IOT38A); also elsewhere on the board
GW_LINK_D6: U4.76 (IOT37B); also elsewhere on the board
GW_LINK_D7: U4.77 (IOT37A); also elsewhere on the board
GW_LINK_D8: U4.48 (IOR24B); also elsewhere on the board
GW_LINK_D9: U4.49 (IOR24A); also elsewhere on the board
GW_LINK_D10: U4.50 (IOR22B); also elsewhere on the board
GW_LINK_D11: U4.53 (IOR15B/DOUT/WE_N); also elsewhere on the board
GW_LINK_D12: U4.54 (IOR15A/DIN/CLKHOLD_N); also elsewhere on the board
GW_LINK_D13: U4.55 (IOR14B/SSPI_CS_N/D0); also elsewhere on the board
GW_LINK_D14: U4.56 (IOR14A/SO/D1); also elsewhere on the board
GW_LINK_D15: U4.57 (IOR13A/FASTRD_N/D3); also elsewhere on the board
GW_LINK_VALID: U4.74 (IOT38B); also elsewhere on the board
JTAG_TCK: U4.6 (IOL11B/TCK); also elsewhere on the board
JTAG_TDI: U4.7 (IOL12B/TDI); also elsewhere on the board
JTAG_TDO: U4.8 (IOL13A/TDO); also elsewhere on the board
JTAG_TMS: U4.5 (IOL11A/TMS); also elsewhere on the board
LINK_EN_RX: U4.40 (IOB33B); also elsewhere on the board
LINK_READY_RX: U4.41 (IOB41A); also elsewhere on the board
LINK_RESET_N_RX: U4.42 (IOB41B); also elsewhere on the board
LINK_TX_EN: U4.47 (IOB43B); also elsewhere on the board
unnamed: C52.1, FB30.2, Y1.1 (EN), Y1.4 (Vdd)
unnamed: R35.1, Y1.3 (OUT)
TF_CS: U4.38 (IOB31B); also elsewhere on the board
TF_MISO: U4.39 (IOB33A); also elsewhere on the board
TF_MOSI: U4.37 (IOB31A); also elsewhere on the board
TF_SCLK: U4.36 (IOB29B/GCLKC_4); also elsewhere on the board
VCCO0_1_2_3V3: C39.1, C40.1, C41.1, C42.1, C43.1, C44.1, C45.1, C46.1, C47.1, C48.1, C49.1, U4.23 (VCCIO2), U4.44 (VCCIO2), U4.58 (VCCIO1), U4.64 (VCCX/VCCIO0), U4.67 (VCCX/VCCIO0), U4.78 (VCCX/VCCIO0); also elsewhere on the board
VCCO3_1V8: C30.1, C31.1, D32.2 (A), D33.2 (A), D34.2 (A), D35.2 (A), D36.2 (A), D37.2 (A), R30.1, R33.1, R34.1, U4.12 (VCCIO3); also elsewhere on the board

Notes on the sheet:
27 MHz oscillator
Configuration: RECONFIG_N and MODE
RECONFIG_N with pull-up and MODE0/MODE1 with 4.7k pull-downs (Tang Nano 9K 3674).
Bank 3 (VCCIO3) at 1V8: JTAG, MODE, buttons and LEDs.
Buttons S1 and S2
S2 is also JTAGSEL_N (pin 4). 10k pull-up, 100nF and ESD per button.
User LEDs (active low)
No series resistor, as on the 3674 (README 16.1).
Gowin decoupling
Pins 53-57 (D11-D15) also carry SSPI/CPU configuration functions: use as I/O in the open flow is Pending.
Bank 1 (pins 48-77): KR260 link; bank 2: UART, microSD and link control. Allocation: Proposed.

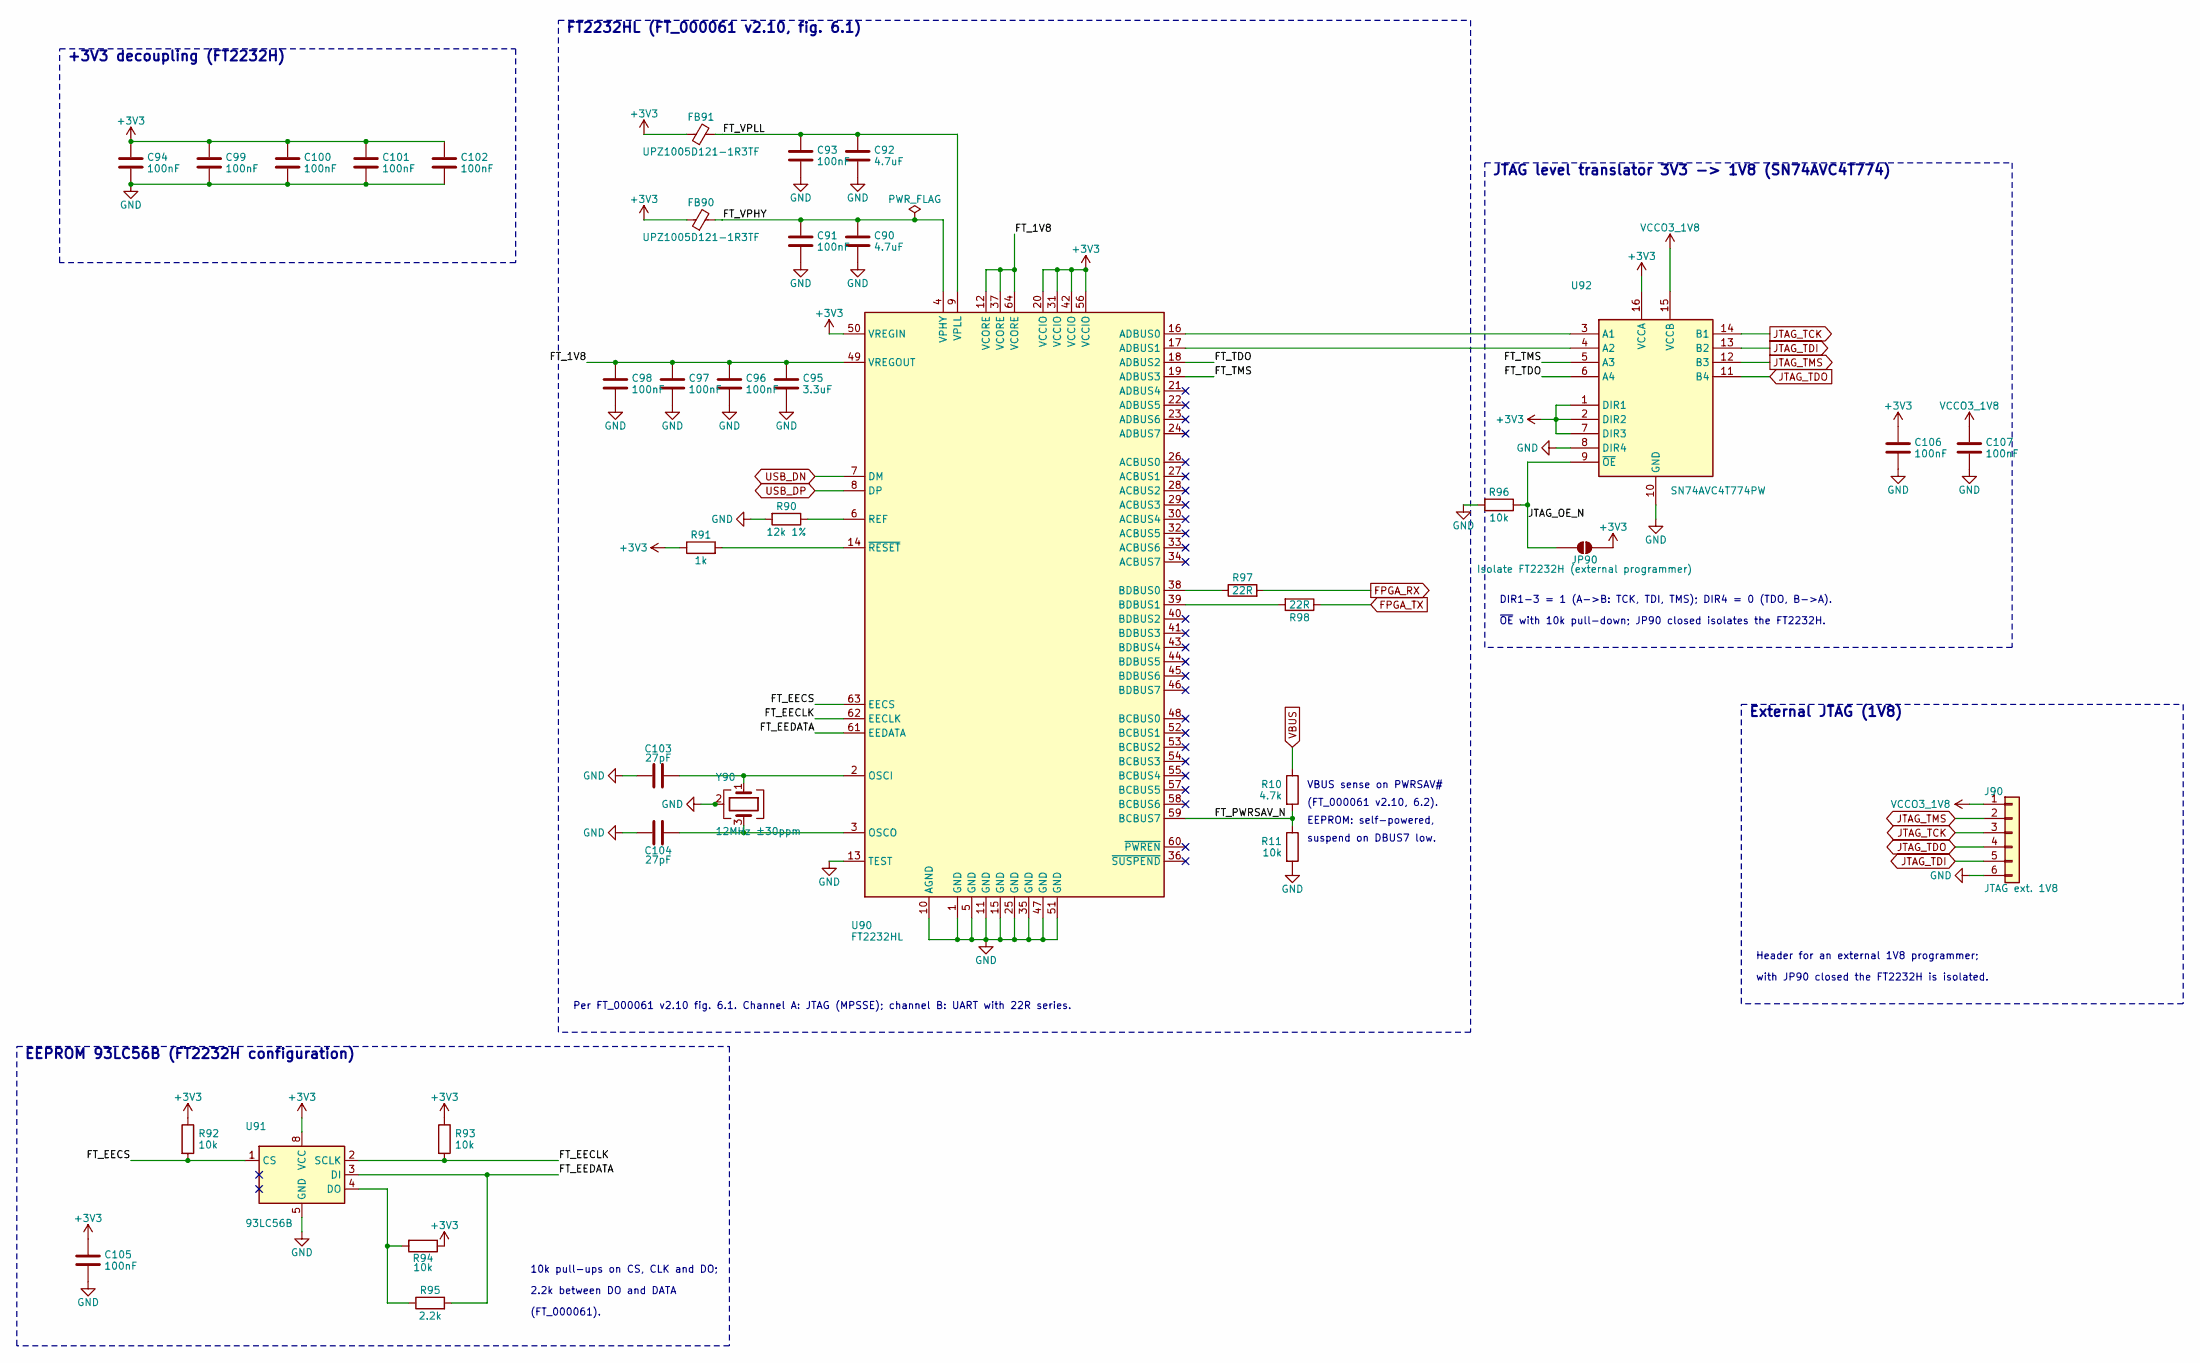
[picture p15: schematic usb_jtag_uart.kicad_sch, FT2232H, JTAG 3V3/1V8, UART]

Parts:
C90, C92: 4.7uF; C_0603_1608Metric
C91, C93, C94, C96, C97, C98, C99, C100, C101, C102, C105, C106, C107: 100nF; C_0402_1005Metric
C95: 3.3uF; C_0603_1608Metric
C103, C104: 27pF; C_0402_1005Metric
FB90, FB91: UPZ1005D121-1R3TF; L_0402_1005Metric
J90: JTAG ext. 1V8; PinHeader_1x06_P2.54mm_Vertical
JP90: Isolate FT2232H (external programmer); SolderJumper-2_P1.3mm_Open_RoundedPad1.0x1.5mm
R10: 4.7k; R_0402_1005Metric
R11, R92, R93, R94, R96: 10k; R_0402_1005Metric
R90: 12k 1%; R_0402_1005Metric
R91: 1k; R_0402_1005Metric
R95: 2.2k; R_0402_1005Metric
R97, R98: 22R; R_0402_1005Metric
U90: FT2232HL; LQFP-64_10x10mm_P0.5mm
U91: 93LC56B; SOIC-8_3.9x4.9mm_P1.27mm
U92: SN74AVC4T774PW; TSSOP-16_4.4x5mm_P0.65mm
Y90: 12MHz ±30ppm; Crystal_SMD_3225-4Pin_3.2x2.5mm

Connections:
+3V3: C94.1, C99.1, C100.1, C101.1, C102.1, C105.1, C106.1, FB90.1, FB91.1, JP90.2 (B), R91.1, R92.1, R93.1, R94.1, U90.20 (VCCIO), U90.31 (VCCIO), U90.42 (VCCIO), U90.50 (VREGIN), U90.56 (VCCIO), U91.8 (VCC), U92.1 (DIR1), U92.2 (DIR2), U92.7 (DIR3), U92.16 (VCCA); also elsewhere on the board
/usb_jtag_uart/FT_1V8: C95.1, C96.1, C97.1, C98.1, U90.12 (VCORE), U90.37 (VCORE), U90.49 (VREGOUT), U90.64 (VCORE)
/usb_jtag_uart/FT_EECLK: R93.2, U90.62 (EECLK), U91.2 (SCLK)
/usb_jtag_uart/FT_EECS: R92.2, U90.63 (EECS), U91.1 (CS)
/usb_jtag_uart/FT_EEDATA: R95.2, U90.61 (EEDATA), U91.3 (DI)
/usb_jtag_uart/FT_PWRSAV_N: R10.2, R11.1, U90.59 (BCBUS7)
/usb_jtag_uart/FT_TDO: U90.18 (ADBUS2), U92.6 (A4)
/usb_jtag_uart/FT_TMS: U90.19 (ADBUS3), U92.5 (A3)
/usb_jtag_uart/FT_VPHY: C90.1, C91.1, FB90.2, U90.4 (VPHY)
/usb_jtag_uart/FT_VPLL: C92.1, C93.1, FB91.2, U90.9 (VPLL)
/usb_jtag_uart/JTAG_OE_N: JP90.1 (A), R96.1, U92.9 (~OE)
FPGA_RX: R97.2; also elsewhere on the board
FPGA_TX: R98.1; also elsewhere on the board
GND: C90.2, C91.2, C92.2, C93.2, C94.2, C95.2, C96.2, C97.2, C98.2, C99.2, C100.2, C101.2, C102.2, C103.2, C104.2, C105.2, C106.2, C107.2, J90.6, R11.2, R90.2, R96.2, U90.1 (GND), U90.5 (GND), U90.10 (AGND), U90.11 (GND), U90.13 (TEST), U90.15 (GND), U90.25 (GND), U90.35 (GND), U90.47 (GND), U90.51 (GND), U91.5 (GND), U92.8 (DIR4), U92.10 (GND), Y90.2 (G), Y90.4 (G); also elsewhere on the board
JTAG_TCK: J90.3, U92.14 (B1); also elsewhere on the board
JTAG_TDI: J90.5, U92.13 (B2); also elsewhere on the board
JTAG_TDO: J90.4, U92.11 (B4); also elsewhere on the board
JTAG_TMS: J90.2, U92.12 (B3); also elsewhere on the board
unnamed: U90.16 (ADBUS0), U92.3 (A1)
unnamed: U90.17 (ADBUS1), U92.4 (A2)
unnamed: R97.1, U90.38 (BDBUS0)
unnamed: R98.2, U90.39 (BDBUS1)
unnamed: C103.1, U90.2 (OSCI), Y90.1
unnamed: C104.1, U90.3 (OSCO), Y90.3
unnamed: R90.1, U90.6 (REF)
unnamed: R91.2, U90.14 (~RESET)
unnamed: R94.2, R95.1, U91.4 (DO)
USB_DN: U90.7 (DM); also elsewhere on the board
USB_DP: U90.8 (DP); also elsewhere on the board
VBUS: R10.1; also elsewhere on the board
VCCO3_1V8: C107.1, J90.1, U92.15 (VCCB); also elsewhere on the board

Notes on the sheet:
FT2232HL (FT_000061 v2.10, fig. 6.1)
VBUS sense on PWRSAV#
(FT_000061 v2.10, 6.2).
EEPROM: self-powered,
suspend on DBUS7 low.
Per FT_000061 v2.10 fig. 6.1. Channel A: JTAG (MPSSE); channel B: UART with 22R series.
JTAG level translator 3V3 -> 1V8 (SN74AVC4T774)
DIR1-3 = 1 (A->B: TCK, TDI, TMS); DIR4 = 0 (TDO, B->A).
~{OE} with 10k pull-down; JP90 closed isolates the FT2232H.
EEPROM 93LC56B (FT2232H configuration)
10k pull-ups on CS, CLK and DO;
2.2k between DO and DATA
(FT_000061).
+3V3 decoupling (FT2232H)
External JTAG (1V8)
Header for an external 1V8 programmer;
with JP90 closed the FT2232H is isolated.

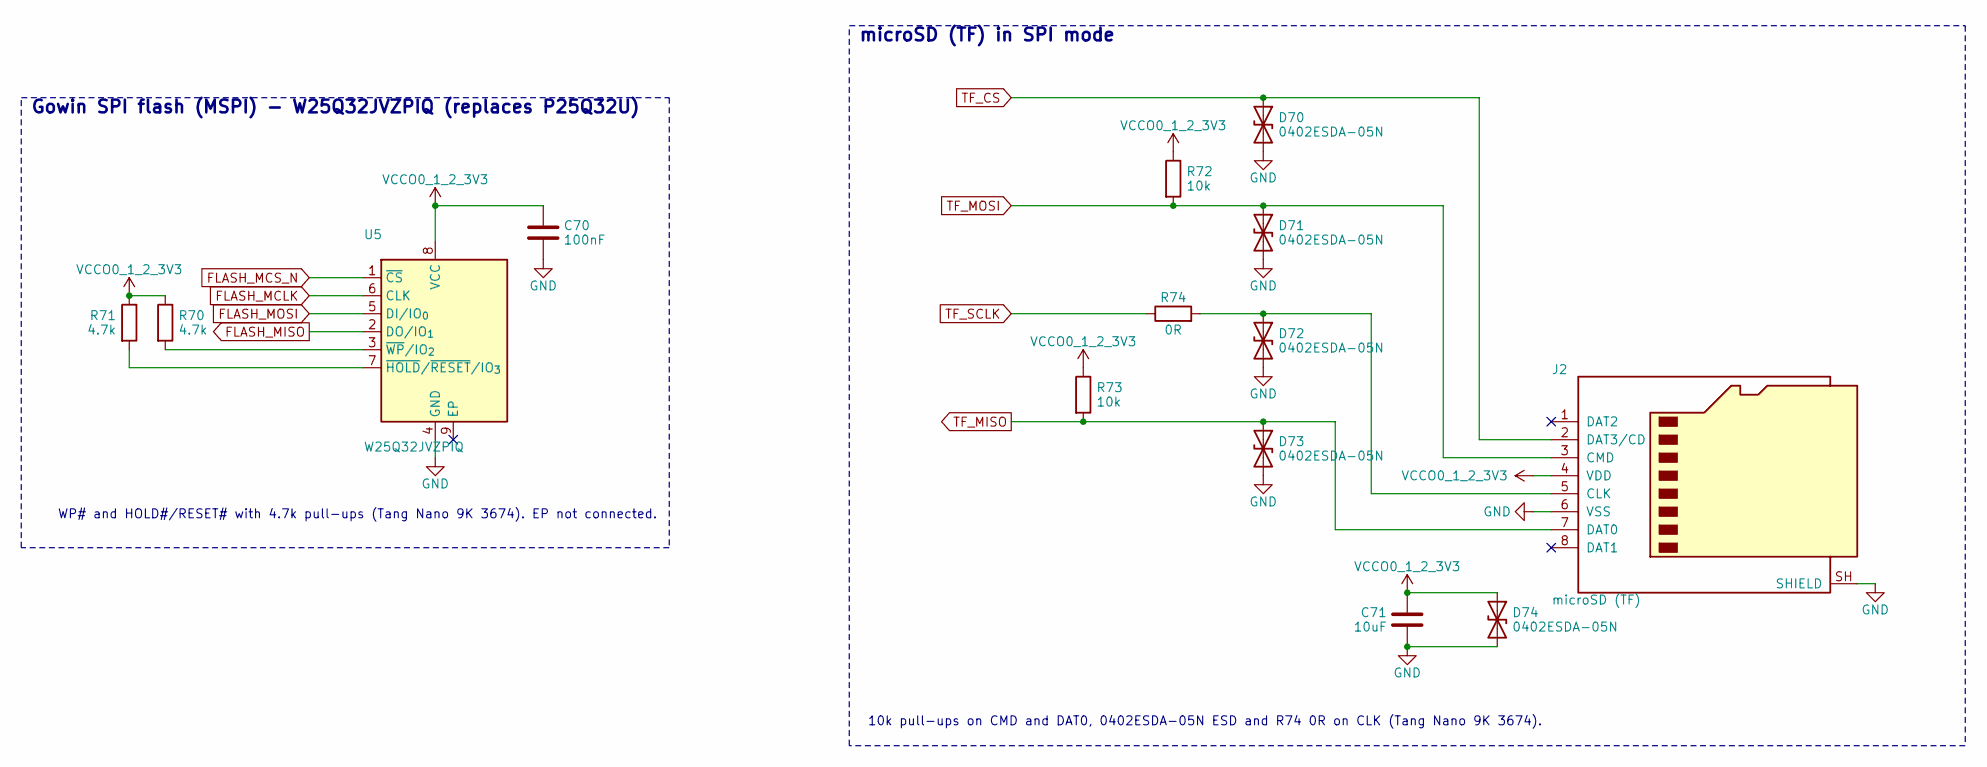
[picture p16: schematic flash_microsd.kicad_sch, SPI flash W25Q32JV and microSD]

Parts:
C70: 100nF; C_0402_1005Metric
C71: 10uF; C_0603_1608Metric
D70, D71, D72, D73, D74: 0402ESDA-05N; D_0402_1005Metric
J2: microSD (TF); microSD_HC_Molex_104031-0811
R70, R71: 4.7k; R_0402_1005Metric
R72, R73: 10k; R_0402_1005Metric
R74: 0R; R_0402_1005Metric
U5: W25Q32JVZPIQ; WSON-8-1EP_6x5mm_P1.27mm_EP3.4x4mm

Connections:
FLASH_MCLK: U5.6 (CLK); also elsewhere on the board
FLASH_MCS_N: U5.1 (~CS); also elsewhere on the board
FLASH_MISO: U5.2 (DO/IO_{1}); also elsewhere on the board
FLASH_MOSI: U5.5 (DI/IO_{0}); also elsewhere on the board
GND: C70.2, C71.2, D70.2 (A2), D71.2 (A2), D72.2 (A2), D73.2 (A2), D74.2 (A2), J2.6 (VSS), J2.SH (SHIELD), U5.4 (GND); also elsewhere on the board
unnamed: D72.1 (A1), J2.5 (CLK), R74.2
unnamed: R71.2, U5.7 (~HOLD/~RESET/IO_{3})
unnamed: R70.2, U5.3 (~WP/IO_{2})
TF_CS: D70.1 (A1), J2.2 (DAT3/CD); also elsewhere on the board
TF_MISO: D73.1 (A1), J2.7 (DAT0), R73.2; also elsewhere on the board
TF_MOSI: D71.1 (A1), J2.3 (CMD), R72.2; also elsewhere on the board
TF_SCLK: R74.1; also elsewhere on the board
VCCO0_1_2_3V3: C70.1, C71.1, D74.1 (A1), J2.4 (VDD), R70.1, R71.1, R72.1, R73.1, U5.8 (VCC); also elsewhere on the board

Notes on the sheet:
Gowin SPI flash (MSPI) - W25Q32JVZPIQ (replaces P25Q32U)
WP# and HOLD#/RESET# with 4.7k pull-ups (Tang Nano 9K 3674). EP not connected.
microSD (TF) in SPI mode
10k pull-ups on CMD and DAT0, 0402ESDA-05N ESD and R74 0R on CLK (Tang Nano 9K 3674).

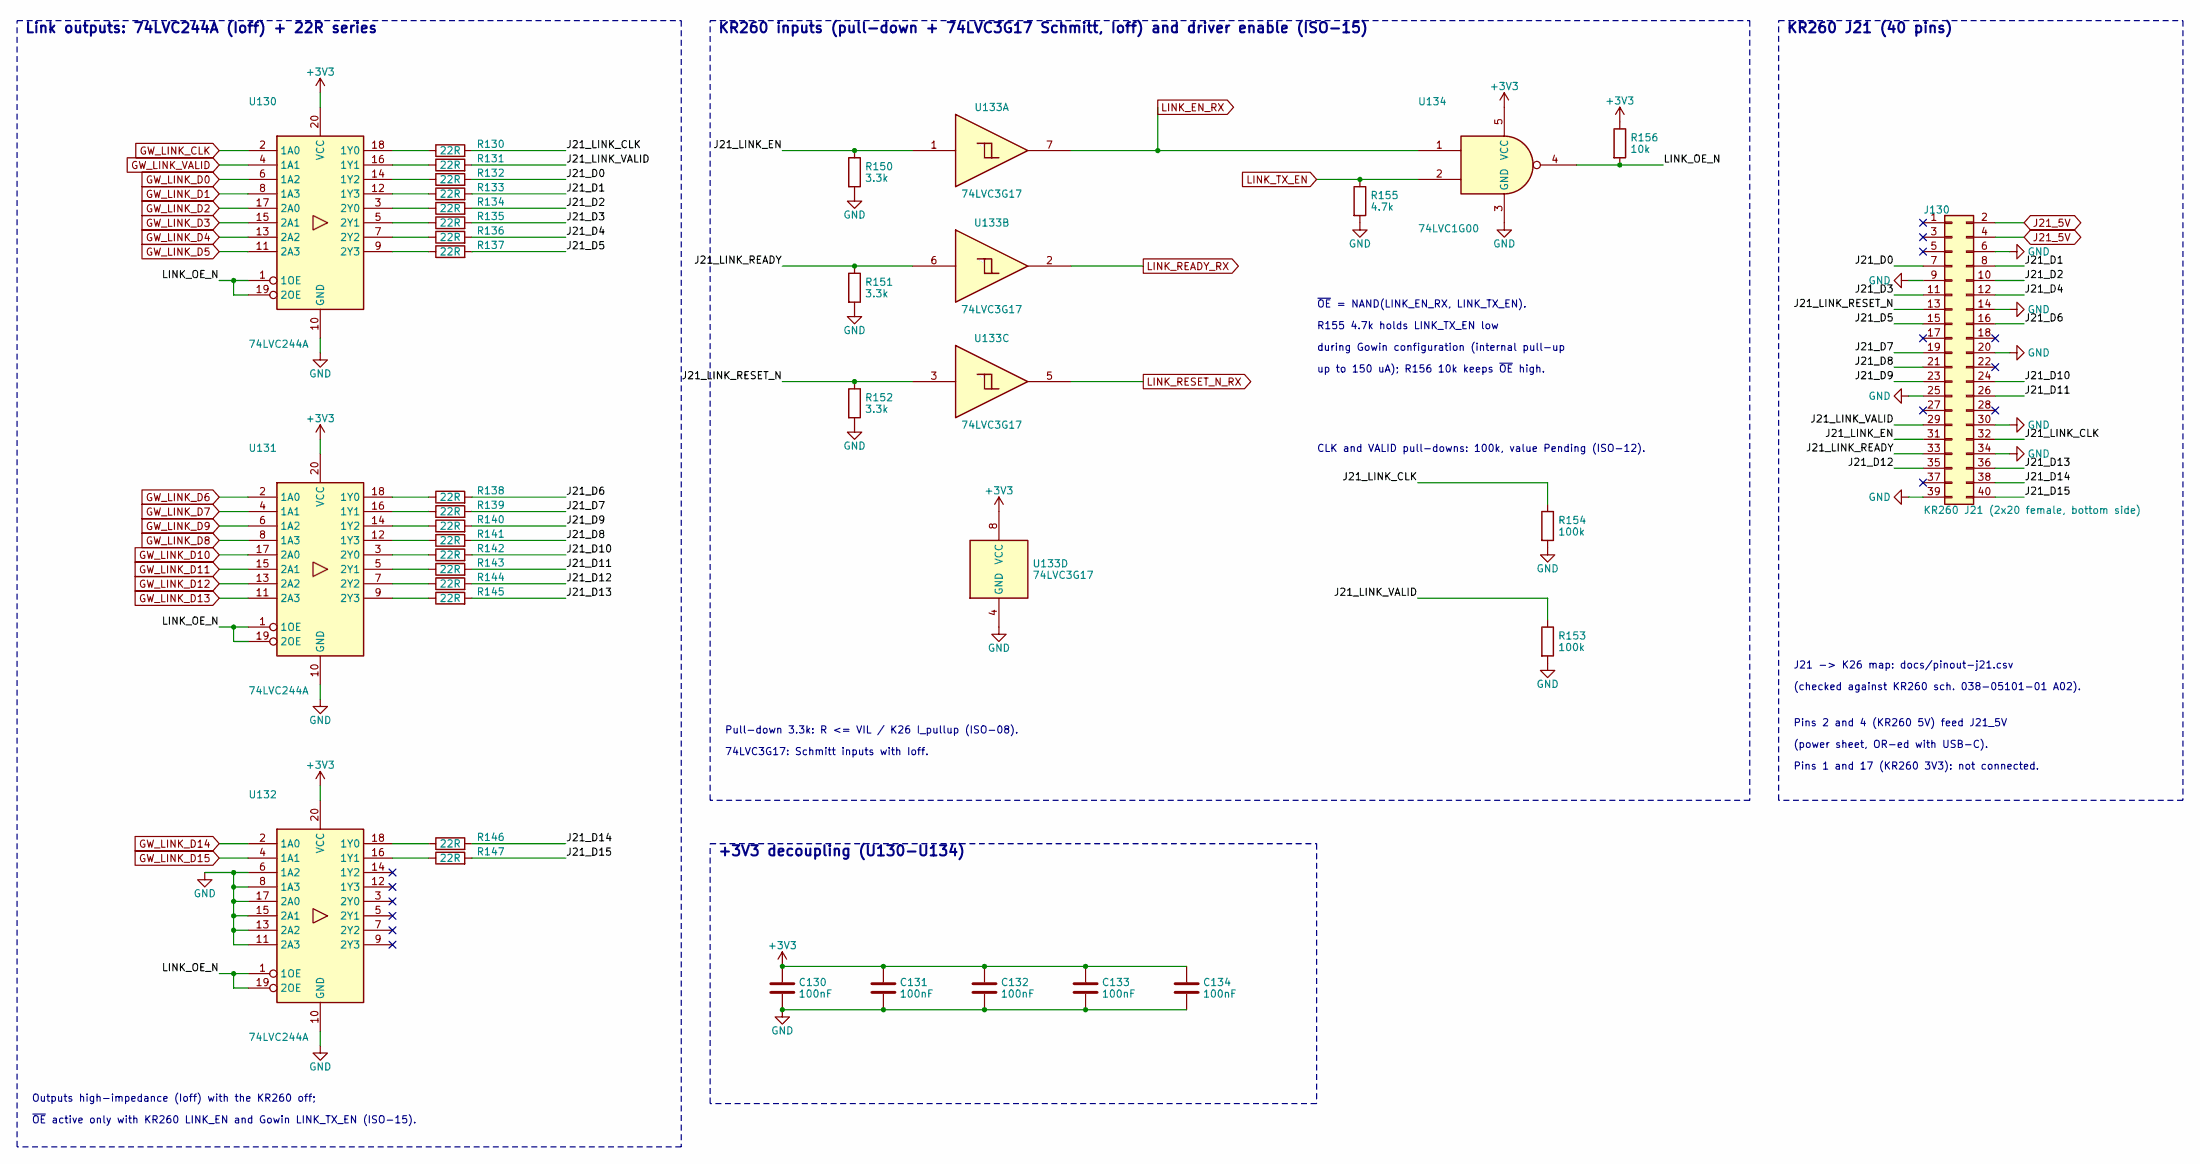
[picture p17: schematic j21_interface.kicad_sch, KR260 J21 interface: Ioff buffers, LINK_EN]

Parts:
C130, C131, C132, C133, C134: 100nF; C_0402_1005Metric
J130: KR260 J21 (2x20 female, bottom side); PinSocket_2x20_P2.54mm_Vertical
R130, R131, R132, R133, R134, R135, R136, R137, R138, R139, R140, R141, R142, R143, R144, R145, R146, R147: 22R; R_0402_1005Metric
R150, R151, R152: 3.3k; R_0402_1005Metric
R153, R154: 100k; R_0402_1005Metric
R155: 4.7k; R_0402_1005Metric
R156: 10k; R_0402_1005Metric
U130, U131, U132: 74LVC244A; TSSOP-20_4.4x6.5mm_P0.65mm
U133: 74LVC3G17; VSSOP-8_2.3x2mm_P0.5mm
U134: 74LVC1G00; SOT-23-5

Connections:
+3V3: C130.1, C131.1, C132.1, C133.1, C134.1, R156.1, U130.20 (VCC), U131.20 (VCC), U132.20 (VCC), U133.8 (VCC), U134.5 (VCC); also elsewhere on the board
/j21_interface/J21_D0: J130.7, R132.2
/j21_interface/J21_D1: J130.8, R133.2
/j21_interface/J21_D2: J130.10, R134.2
/j21_interface/J21_D3: J130.11, R135.2
/j21_interface/J21_D4: J130.12, R136.2
/j21_interface/J21_D5: J130.15, R137.2
/j21_interface/J21_D6: J130.16, R138.2
/j21_interface/J21_D7: J130.19, R139.2
/j21_interface/J21_D8: J130.21, R141.2
/j21_interface/J21_D9: J130.23, R140.2
/j21_interface/J21_D10: J130.24, R142.2
/j21_interface/J21_D11: J130.26, R143.2
/j21_interface/J21_D12: J130.35, R144.2
/j21_interface/J21_D13: J130.36, R145.2
/j21_interface/J21_D14: J130.38, R146.2
/j21_interface/J21_D15: J130.40, R147.2
/j21_interface/J21_LINK_CLK: J130.32, R130.2, R154.1
/j21_interface/J21_LINK_EN: J130.31, R150.1, U133.1
/j21_interface/J21_LINK_READY: J130.33, R151.1, U133.6
/j21_interface/J21_LINK_RESET_N: J130.13, R152.1, U133.3
/j21_interface/J21_LINK_VALID: J130.29, R131.2, R153.1
/j21_interface/LINK_OE_N: R156.2, U130.1 (1OE), U130.19 (2OE), U131.1 (1OE), U131.19 (2OE), U132.1 (1OE), U132.19 (2OE), U134.4
GND: C130.2, C131.2, C132.2, C133.2, C134.2, J130.6, J130.9, J130.14, J130.20, J130.25, J130.30, J130.34, J130.39, R150.2, R151.2, R152.2, R153.2, R154.2, R155.2, U130.10 (GND), U131.10 (GND), U132.6 (1A2), U132.8 (1A3), U132.10 (GND), U132.11 (2A3), U132.13 (2A2), U132.15 (2A1), U132.17 (2A0), U133.4 (GND), U134.3 (GND); also elsewhere on the board
GW_LINK_CLK: U130.2 (1A0); also elsewhere on the board
GW_LINK_D0: U130.6 (1A2); also elsewhere on the board
GW_LINK_D1: U130.8 (1A3); also elsewhere on the board
GW_LINK_D2: U130.17 (2A0); also elsewhere on the board
GW_LINK_D3: U130.15 (2A1); also elsewhere on the board
GW_LINK_D4: U130.13 (2A2); also elsewhere on the board
GW_LINK_D5: U130.11 (2A3); also elsewhere on the board
GW_LINK_D6: U131.2 (1A0); also elsewhere on the board
GW_LINK_D7: U131.4 (1A1); also elsewhere on the board
GW_LINK_D8: U131.8 (1A3); also elsewhere on the board
GW_LINK_D9: U131.6 (1A2); also elsewhere on the board
GW_LINK_D10: U131.17 (2A0); also elsewhere on the board
GW_LINK_D11: U131.15 (2A1); also elsewhere on the board
GW_LINK_D12: U131.13 (2A2); also elsewhere on the board
GW_LINK_D13: U131.11 (2A3); also elsewhere on the board
GW_LINK_D14: U132.2 (1A0); also elsewhere on the board
GW_LINK_D15: U132.4 (1A1); also elsewhere on the board
GW_LINK_VALID: U130.4 (1A1); also elsewhere on the board
J21_5V: J130.2, J130.4; also elsewhere on the board
LINK_EN_RX: U133.7, U134.1; also elsewhere on the board
LINK_READY_RX: U133.2; also elsewhere on the board
LINK_RESET_N_RX: U133.5; also elsewhere on the board
LINK_TX_EN: R155.1, U134.2; also elsewhere on the board
unnamed: R130.1, U130.18 (1Y0)
unnamed: R131.1, U130.16 (1Y1)
unnamed: R132.1, U130.14 (1Y2)
unnamed: R133.1, U130.12 (1Y3)
unnamed: R134.1, U130.3 (2Y0)
unnamed: R135.1, U130.5 (2Y1)
unnamed: R136.1, U130.7 (2Y2)
unnamed: R137.1, U130.9 (2Y3)
unnamed: R138.1, U131.18 (1Y0)
unnamed: R139.1, U131.16 (1Y1)
unnamed: R140.1, U131.14 (1Y2)
unnamed: R141.1, U131.12 (1Y3)
unnamed: R142.1, U131.3 (2Y0)
unnamed: R143.1, U131.5 (2Y1)
unnamed: R144.1, U131.7 (2Y2)
unnamed: R145.1, U131.9 (2Y3)
unnamed: R146.1, U132.18 (1Y0)
unnamed: R147.1, U132.16 (1Y1)

Notes on the sheet:
Link outputs: 74LVC244A (Ioff) + 22R series
Outputs high-impedance (Ioff) with the KR260 off;
~{OE} active only with KR260 LINK_EN and Gowin LINK_TX_EN (ISO-15).
KR260 inputs (pull-down + 74LVC3G17 Schmitt, Ioff) and driver enable (ISO-15)
Pull-down 3.3k: R <= VIL / K26 I_pullup (ISO-08).
74LVC3G17: Schmitt inputs with Ioff.
~{OE} = NAND(LINK_EN_RX, LINK_TX_EN).
R155 4.7k holds LINK_TX_EN low
during Gowin configuration (internal pull-up
up to 150 uA); R156 10k keeps ~{OE} high.
CLK and VALID pull-downs: 100k, value Pending (ISO-12).
+3V3 decoupling (U130-U134)
KR260 J21 (40 pins)
J21 -> K26 map: docs/pinout-j21.csv
(checked against KR260 sch. 038-05101-01 A02).
Pins 2 and 4 (KR260 5V) feed J21_5V
(power sheet, OR-ed with USB-C).
Pins 1 and 17 (KR260 3V3): not connected.
