calperxd/tangnano9k-kr260-hat/hardware/tangnano9k-kr260-hat.kicad_pcb

## KiCad design hardware/tangnano9k-kr260-hat.kicad_pcb (continued)

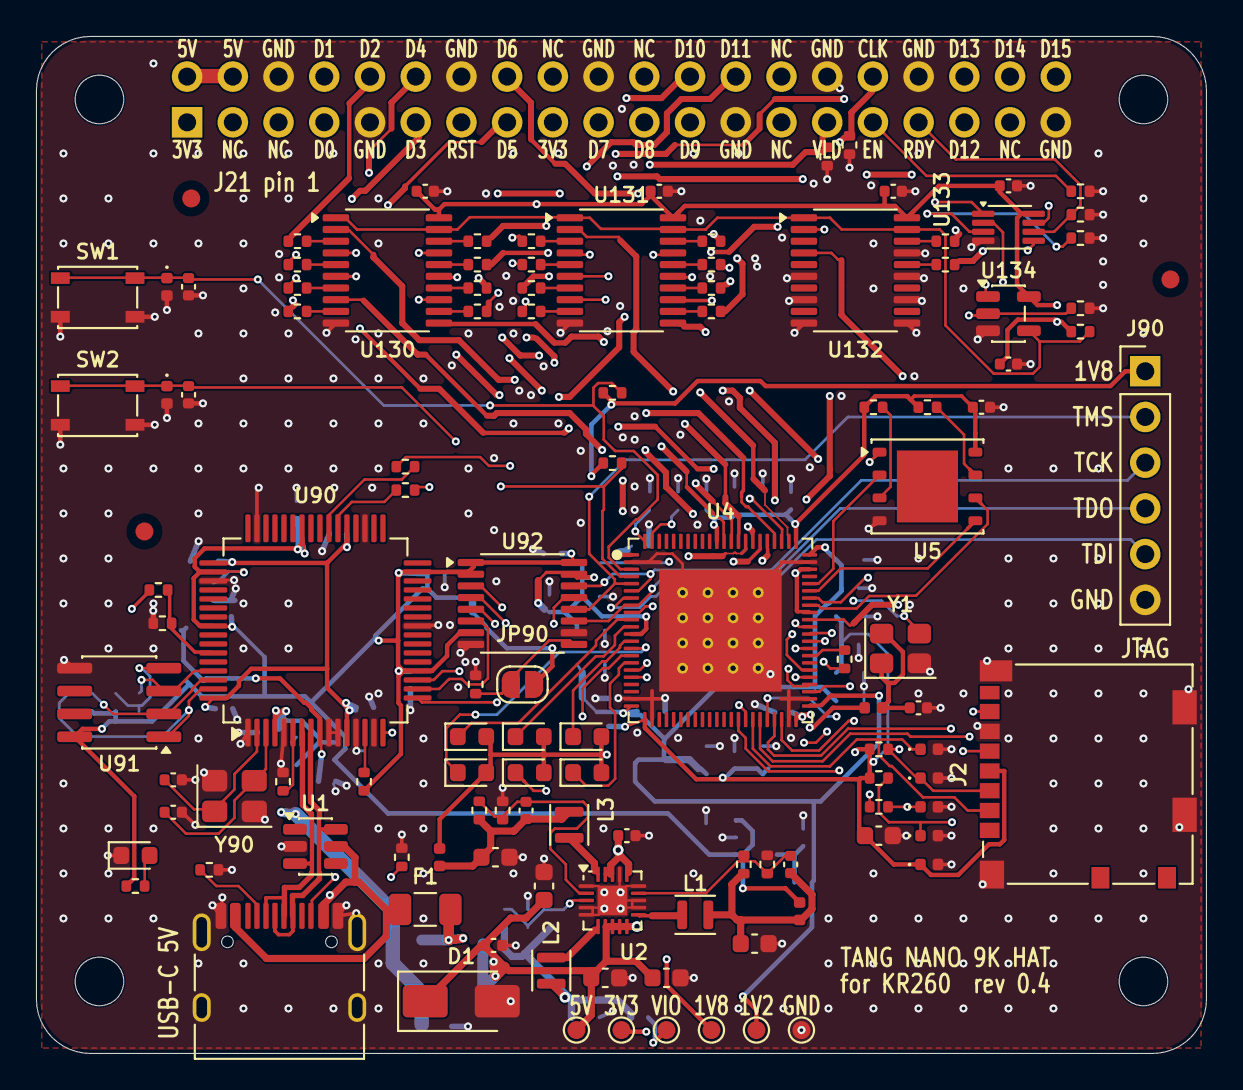
[picture p18: board tangnano9k-kr260-hat.kicad_pcb from above]

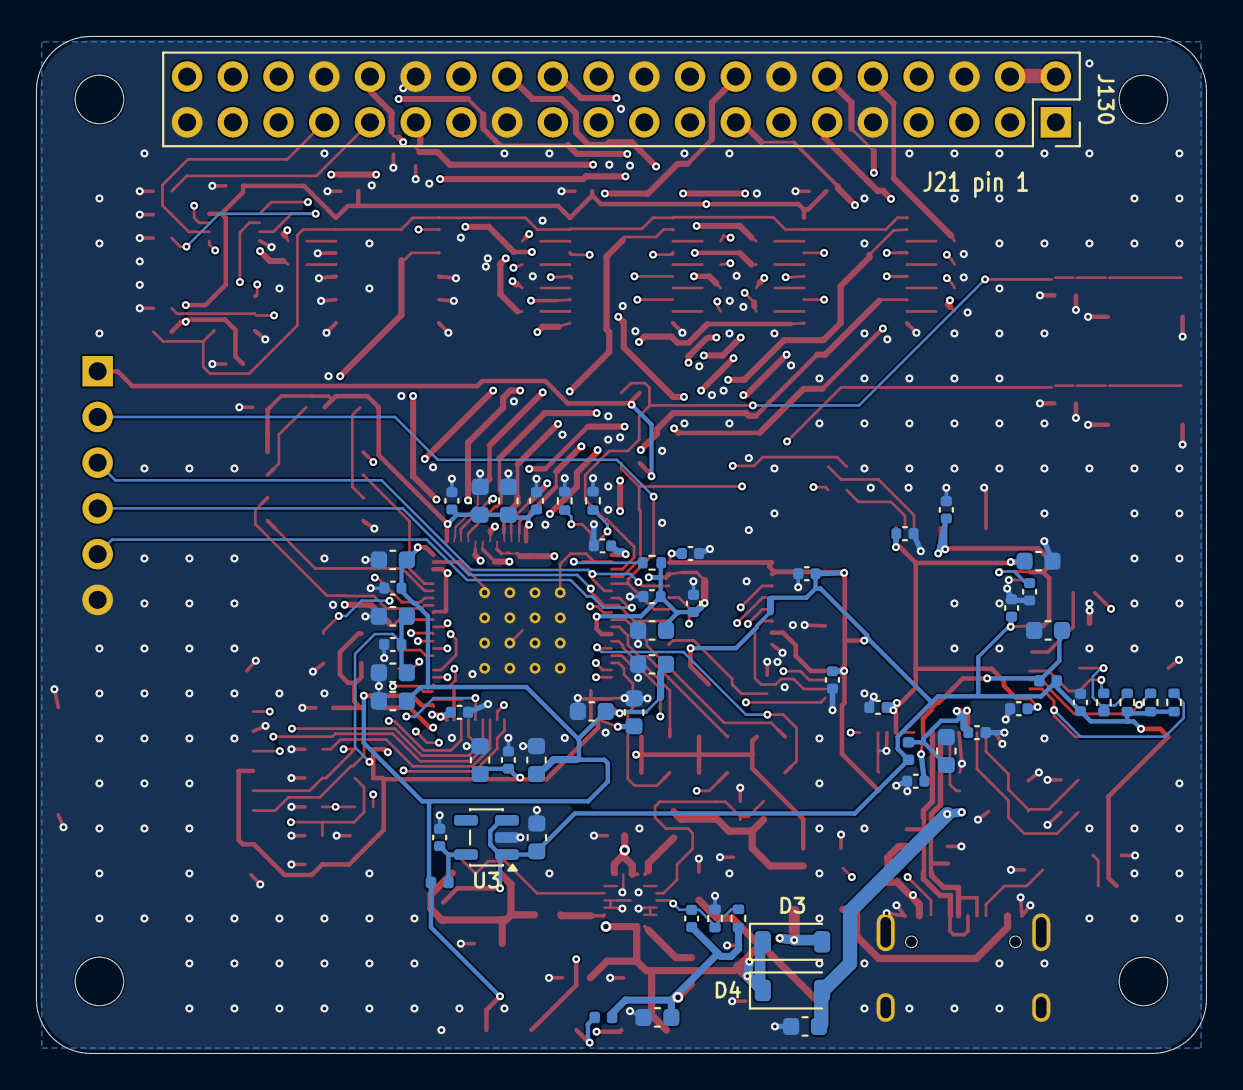
[picture p19: board tangnano9k-kr260-hat.kicad_pcb from below]

Board: 4 copper layers, 65.0 x 56.5 mm, 181 parts (58 on the bottom side), 136 nets.

Other parts of the board:
FID1, FID2, FID3: Fiducial_1mm_Mask2mm
H1, H2, H3, H4: MountingHole_2.7mm_M2.5
