calperxd/tangnano9k-kr260-hat/(commit log)

2026-10-21 Tang Nano 9K HAT for KR260: spec, KiCad project and JLCPCB files
    - README.md: requirements specification, rev 0.6
    - docs/: J21 <-> K26 <-> HAT pinout (CSV and Markdown)
    - hardware/: KiCad 10 schematic and 4-layer PCB (board rev 0.4), powered
    from the USB-C or the KR260 J21 5 V through Schottky OR-ing
    - hardware/production/: JLCPCB Gerber/drill, BOM and CPL, the script that
    generates them and the LCSC part table
    - hardware/3d, hardware/renders: STEP model and board renders
    [flash_microsd.kicad_sch, fpga.kicad_sch, j21_interface.kicad_sch, jlcpcb_parts.csv, pinout-j21.csv, power.kicad_sch, tangnano9k-kr260-hat.kicad_pcb, tangnano9k-kr260-hat.kicad_sch]
2026-10-21 Add board renders to the README and an all-rights-reserved license
    - README: 3D render of the top side and plan views of both sides
    - hardware/renders: 3D views re-rendered with the whole board in frame
    - LICENSE: all rights reserved; published for portfolio and reference
2026-10-21 Check the TMI7003C against its datasheet and add its LCSC number
    - README rev 0.7: TMI7003C pinout and 2.5-5.5 V input range checked
    against datasheet V1.5; the dual-power +5V is within that range
    - BOM: TMI7003C matched to JLCPCB/LCSC C840566; only the GW1NR still
    needs Global Sourcing or consignment
    [jlcpcb_parts.csv, tangnano9k-kr260-hat_rev0.4_bom_jlcpcb.csv]
2026-10-21 Document the fully assembled order
    - Production README: pre-order the TMI7003C and get the GW1NR through
    JLCPCB Global Sourcing before the PCBA order; both headers assembled
    - README: board ordered fully assembled; J90 no longer optional
2026-10-21 Centre the pin header and socket in the JLCPCB placement file
    KiCad puts the origin of J90 and J130 on pin 1, with the pins along Y;
    the JLCPCB footprints are centred, with the pins along X. make_jlcpcb.py
    now writes pin headers and sockets at the centre of their pads (from an
    IPC-D-356 export) and turns them by -90 degrees. Other parts unchanged.
    [tangnano9k-kr260-hat_rev0.4_cpl_jlcpcb.csv]
2026-11-03 Re-route the J21 link over ground planes and move decoupling capacitors to their pins (#1)
    * Re-route the J21 link at 50 ohm over ground planes
    Route the 36 link nets (GW_LINK_* and J21_*) on F.Cu over the In1
    ground plane and on In2 between ground pours, at the 50 ohm widths of
    the JLC04161H-7628 stack-up: 0.34 mm on F.Cu and 0.32 mm on In2, with
    a 0.10 mm neck-down only at the GW1NR pin escape. Add a ground pour on
    In2 and a ground via next to every layer change. Put the R153/R154
    pull-downs in line near J130.
    Swap D8 and D9 between U131 channels 1A2/1Y2 and 1A3/1Y3 (and R140/
    R141) so the escapes from GW1NR pins 48 and 49 no longer cross. The
    GW1NR and J21 pins do not change; docs/pinou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
    [j21_interface.kicad_sch, pinout-j21.csv, tangnano9k-kr260-hat.kicad_pcb]
